casartar/Spiralboard/README.md

# Spiralboard

[Hier](Doku/Doku.md) gehts zur Anleitung.

## iBOM
[ibom.html](https://html-preview.github.io/?url=https://github.com/casartar/Spiralboard/blob/main/PCB/bom/ibom.html)
