casartar/Spiralboard/Doku/BeispielConfig/README.md

### Beispiele für die ledmap

- dazu muss das Spiralboard mit einem Netzwerk mit INternet verbunden sein, da sonst der editor nicht erreichbar ist.
- unter IP-SPIRALBOARD/edit ist dieser dann zu erreichen und man kann die ledmap1.json hochladen.

- wenn man dann in den Settings noch auf 2D Matrix umstellt  (0,0 ist links oben)
- und 64 LEDS anzahl angibt. kann man alle effekte nutzen. sowohl mit ledmap im 2D kontext als auch im 1D Kontext
- pro preset definierbar ob default oder ledmap1
- einige Beispiele dazu sind in der wled_presets.json zu finden

### mit pixart.htm kann man dann versuchen lustige bilder aufs spiralboard zu bekommen.
- auch hochladen über den editor und dann per URL aufrufen....
- rumspielen :)
