casartar/Spiralboard/Doku/Doku.md

# Spiralboard - Lötanleitung

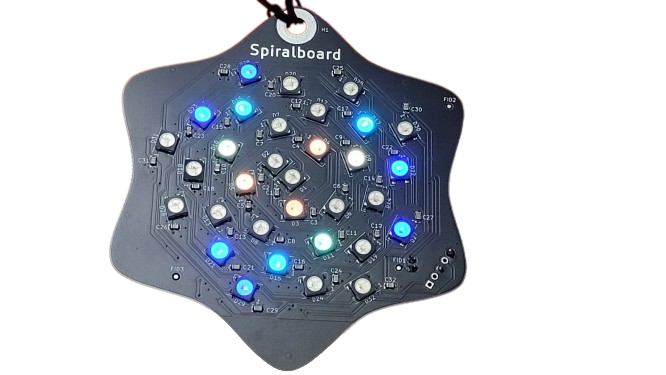
[picture p1: Doku/Bilder/20230919_221744-removebg-preview.png]


Das Spiralboard ist eine Demoplatine, anhand der wir die Fähigkeit unserer Pick and Place Maschine demonstrieren wollen. Darüber hinaus ist sie auch sehr schön anzusehen und macht sehr viel Spaß beim zusammenbauen (Das Spiralboard, nicht die Maschine).

Folgende Schritte sind notwendig um ein Spiralboard zu fertigen:
- Auftragen der Lötpaste Oberseite
- Automatische Bestückung Oberseite
- Backen der Platine
- Handbestücken der Unterseite
- Steuern der LEDs

Je nach Kenntnisstand kannst du alle Schritte, außer der automatischen Bestückung, mithilfe dieser Anleitung selbstständig durchführen. Dabei stehen wir dir jederzeit mit Rat und Tat zur Seite.

**Wichtig:** Bitte lies jeden Schritt erst zuende und schaue dir das Bild dazu an, bevor du anfängst ihn abzuarbeiten.

Das Herz der Platine ist ein **ESP8266-Modul** mit der Open Source Software **WLED**. Mithilfe von WLED kann das Spiralboard auf jede erdenkliche Art und Weise zum Leuchten und Blinken gebracht werden.

Und das von dir! - Mit deinem Smartphone!

## Schritt 1: Auftragen der Lötpaste

### Einlegen der Platine in den Schablonenhalter
Zuerst muss die Platine in den Schablonenhalter eingelegt werden, so dass die Platine rechts und unten an den Metallstegen anliegt. Die weißen Magnetplatten müssen so gegen die Platine geschoben werden, dass sie sich nicht mehr bewegen kann.

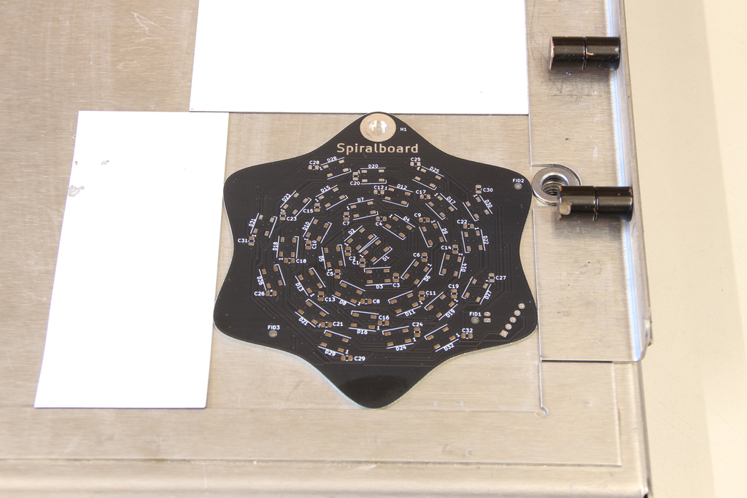
[picture p2: Doku/Bilder/IMG_8405.JPG]


### Auflegen der Lötschablone
Nun muss die Lötschablone (auch Stencil genannt) so auf die Platine aufgelegt werden, dass die Löcher in der Schablone und die silbernen Pads der Platine perfekt übereinander liegen.

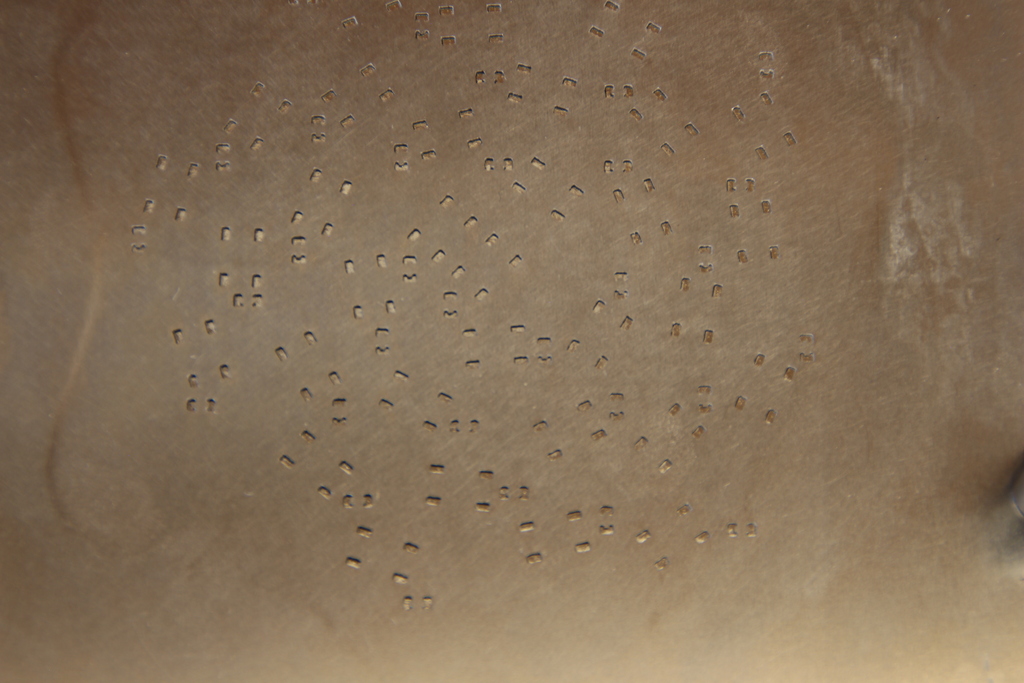
[picture p3: Doku/Bilder/IMG_8409.JPG]


Wenn alles perfekt passt, muss die Lötschablone mit den schwarzen Magneten am Scharnier des Schablonenhalters befestigt werden. Dabei muss darauf geachtet werden, dass die Schablone nicht wieder verrutscht. Das Scharnier beginnt erst ab ca. 2 cm von der unteren rechten Ecke. Die Magnete müssen also oberhalb platziert werden.

**Achtung**: Die Magnete sind ziemlich stark.

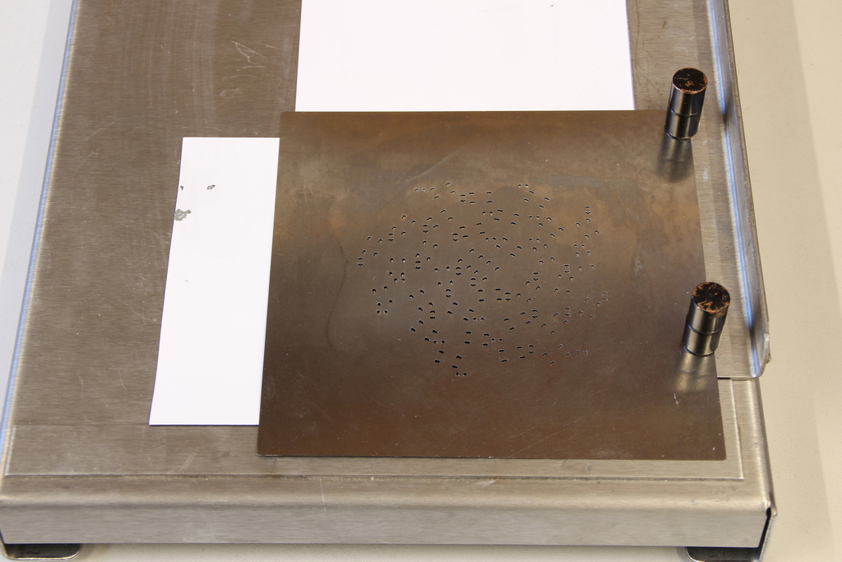
[picture p4: Doku/Bilder/IMG_8408.JPG]


### Auftragen der Lötpaste

Am unteren Rand der Lötschablone muss eine dünne Wurst aus Lötpaste aufgetragen werden. Die Wurst muss so breit sein, dass beim Rakeln alle Löcher in der Schablone gefüllt werden können.

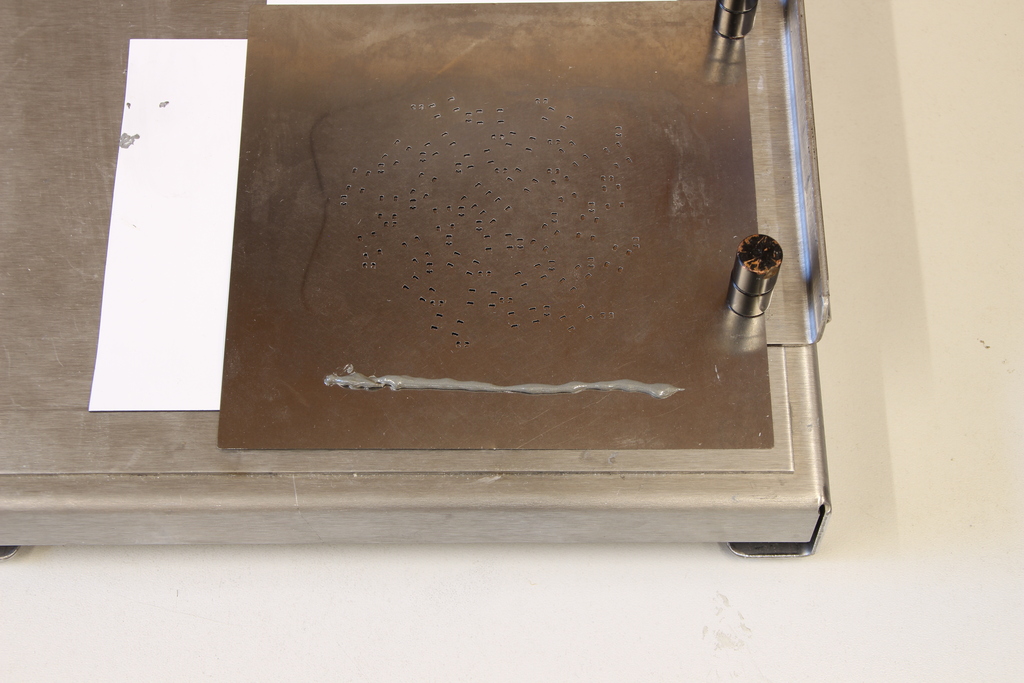
[picture p5: Doku/Bilder/IMG_8410.JPG]


Mit zwei Fingern wird die Lötschablone am unteren Rand fixiert und mit dem Rakel wird die Lötpaste über die Schablone gezogen. Dabei muss mit dem Daumen Druck auf den Rakel ausgeübt werden, damit die Lötpaste sich gut in die Öffnungen setzen kann.

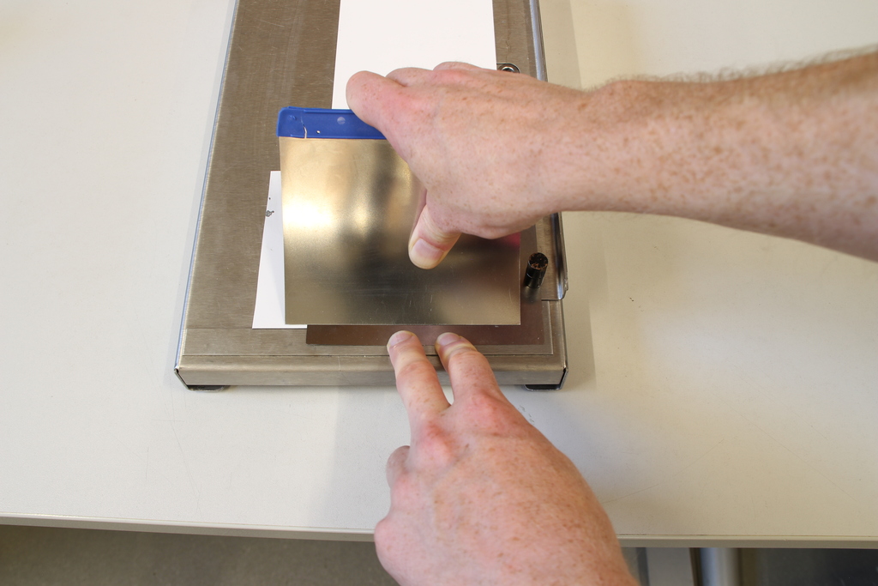
[picture p6: Doku/Bilder/IMG_8411.JPG]


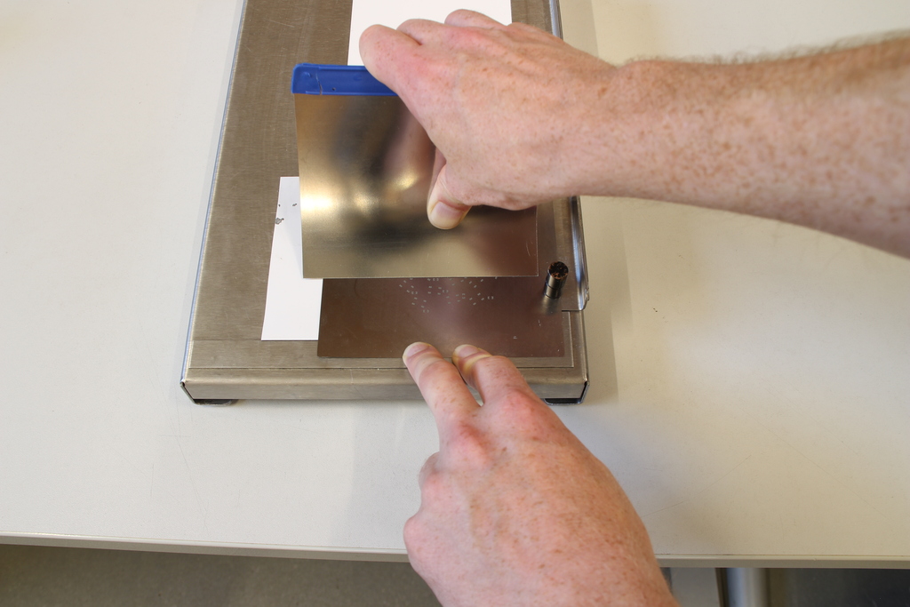
[picture p7: Doku/Bilder/IMG_8412.JPG]


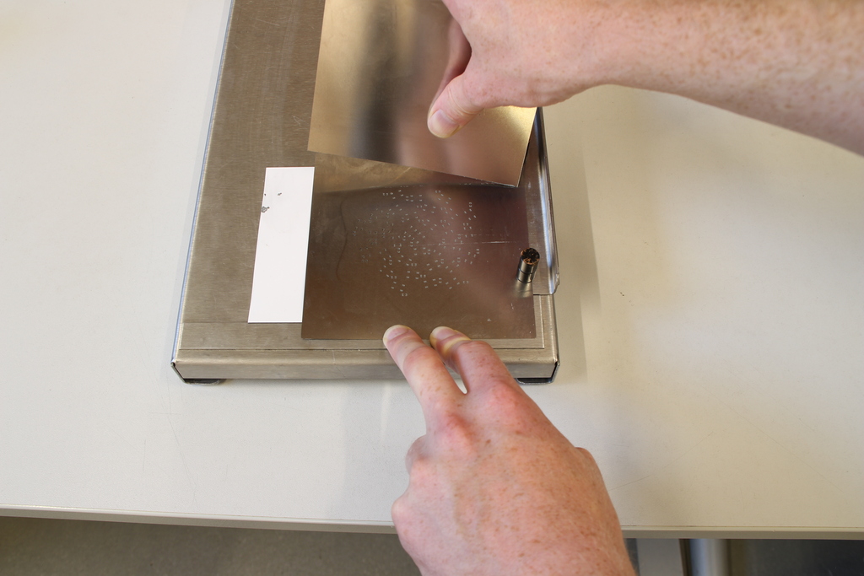
[picture p8: Doku/Bilder/IMG_8413.JPG]


Zum Entfernen der Schablone wird mit dem rechten Daumen das Scharnier des Schablonenhalters blockiert und mit dem linken Zeigefinger die linke untere Ecke der Schablone angehoben. 

Hier muss darauf geachtet werden, dass die Schablone nicht zurückfällt, sonst kann die Lötpaste verschmiert werden.

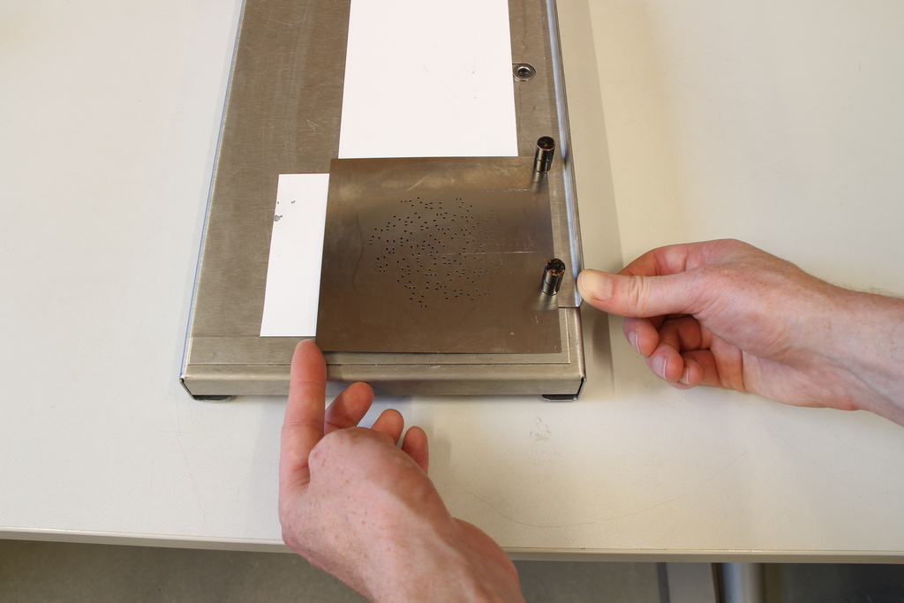
[picture p9: Doku/Bilder/IMG_8414.JPG]


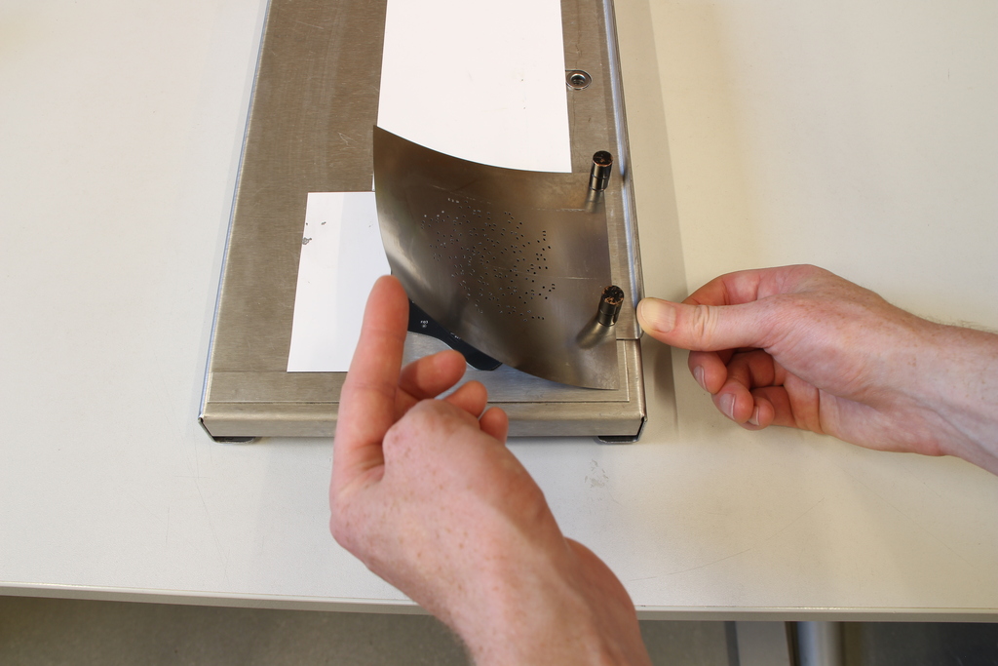
[picture p10: Doku/Bilder/IMG_8415.JPG]


Nachdem sich die Schablone komplett von der Platine gelöst hat, kann die Blockierung des Scharniers gelöst werden und das Scharnier mit der Schablone aufgeklappt werden.

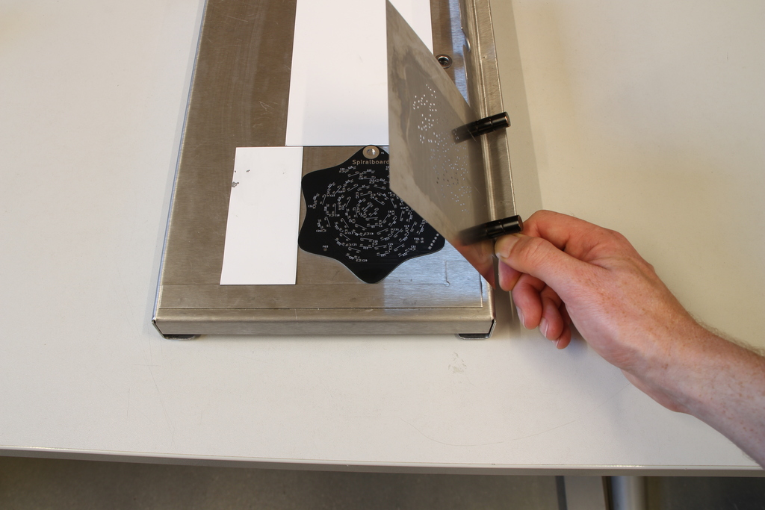
[picture p11: Doku/Bilder/IMG_8416.JPG]


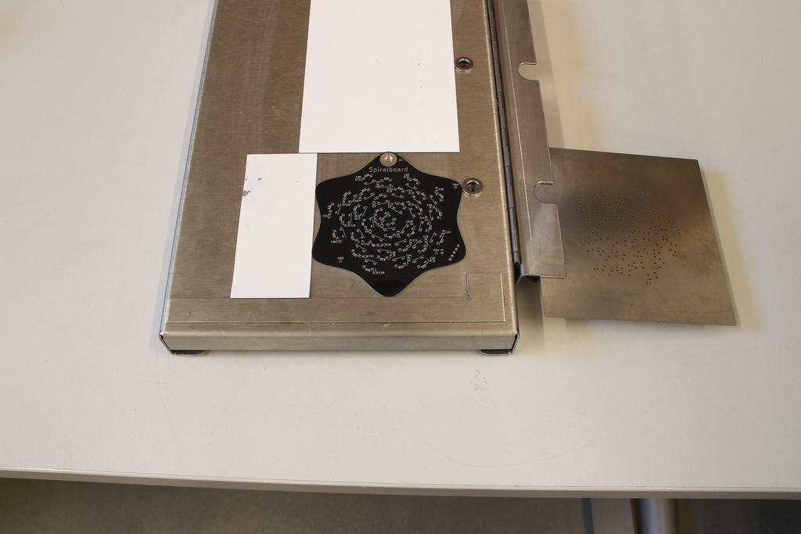
[picture p12: Doku/Bilder/IMG_8417.JPG]


Nun folgt die Kontrolle, ob die Lötpaste bündig auf den Pads aufgetragen ist. Ist dies nicht der Fall, muss die Platine zuerst komplett gereinigt und dann der ganze Vorgang wiederholt werden.

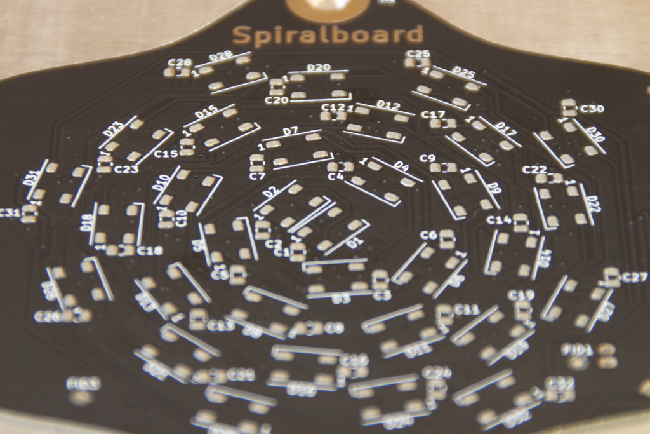
[picture p13: Doku/Bilder/IMG_8418.JPG]


## Schritt 2: Automatische Bestückung

Die Oberseite der Platine wird automatisch in der Pick and Place Maschine bestückt. Dazu muss die Platine in den dafür vorgesehenen Halter eingelegt werden.

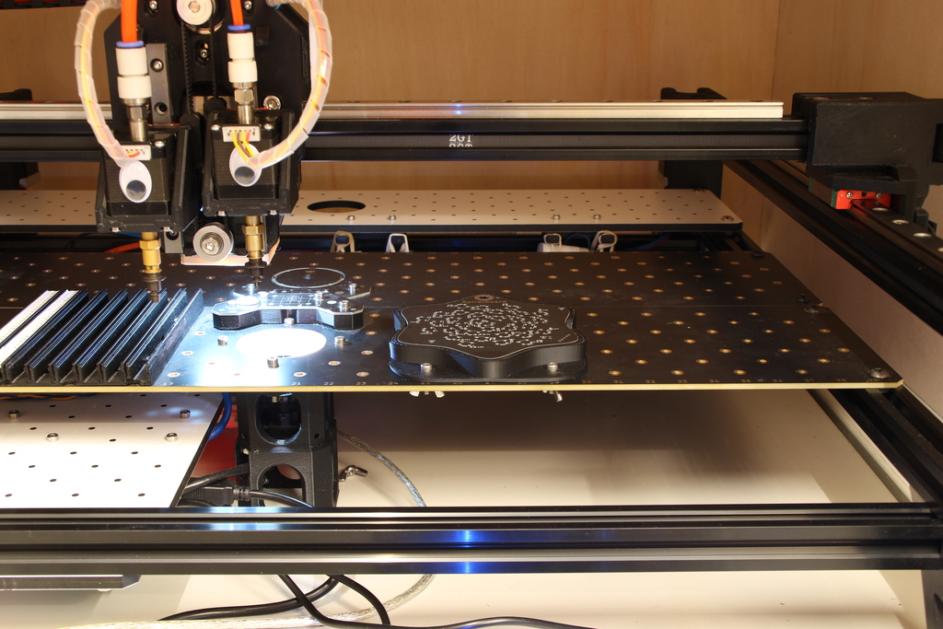
[picture p14: Doku/Bilder/IMG_8419.JPG]


Auf der Oberseite werden die LEDs und 100 nF Kondensatoren platziert.

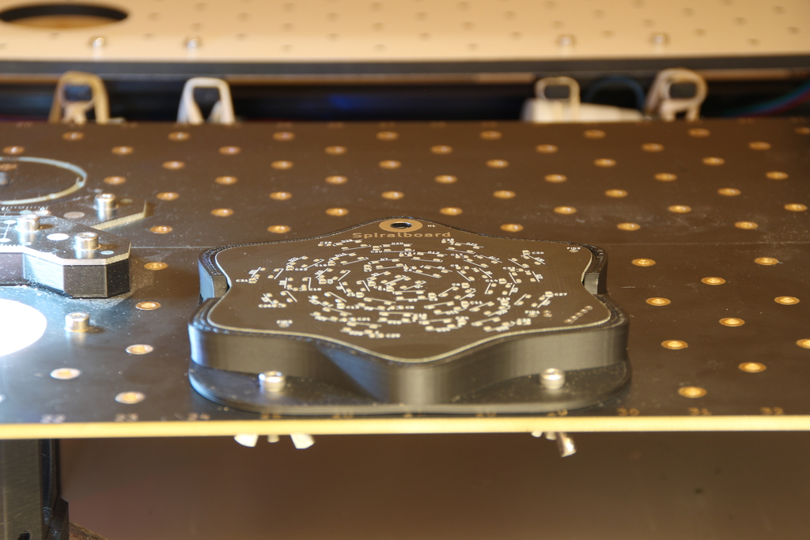
[picture p15: Doku/Bilder/IMG_8420.JPG]


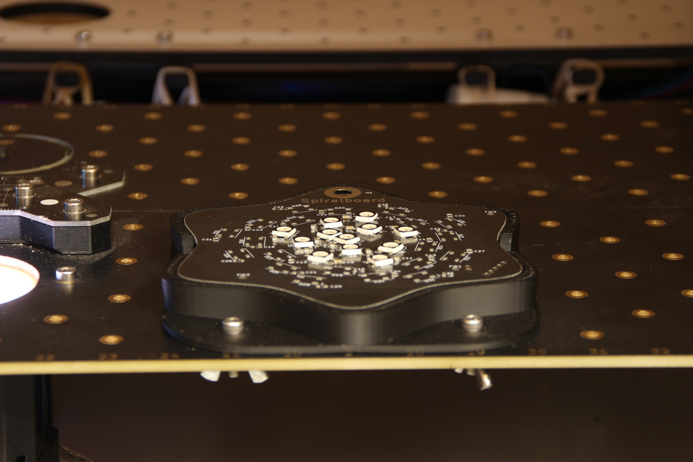
[picture p16: Doku/Bilder/IMG_8421.JPG]


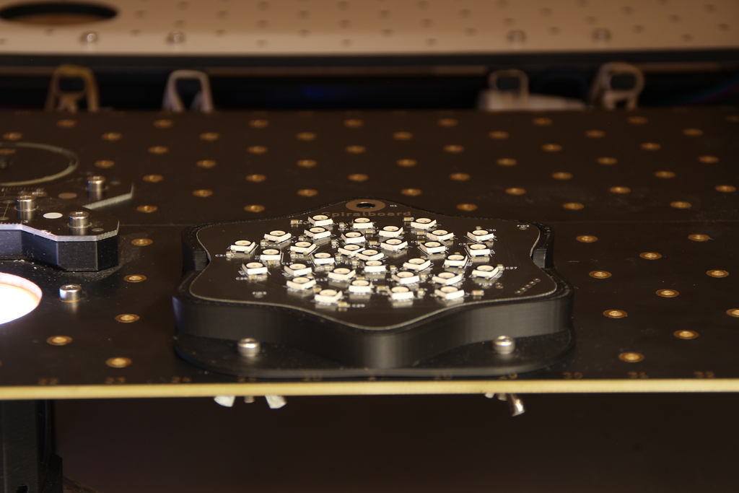
[picture p17: Doku/Bilder/IMG_8422.JPG]


## Backen der Platine

Die bestückte Platine muss jetzt im Lötofen gebacken werden.

Dazu wird die Platine vorsichtig mittig in den Ofen eingelegt, die Tür geschlossen, der Timer maximal aufgezogen und der Heizvorgang mit dem grünen Taster gestartet.

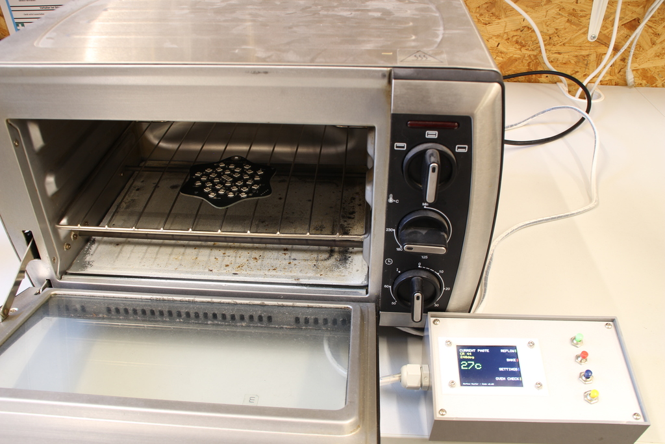
[picture p18: Doku/Bilder/IMG_8423.JPG]


Auf dem Display kann der Temperaturverlauf verfolgt werden.

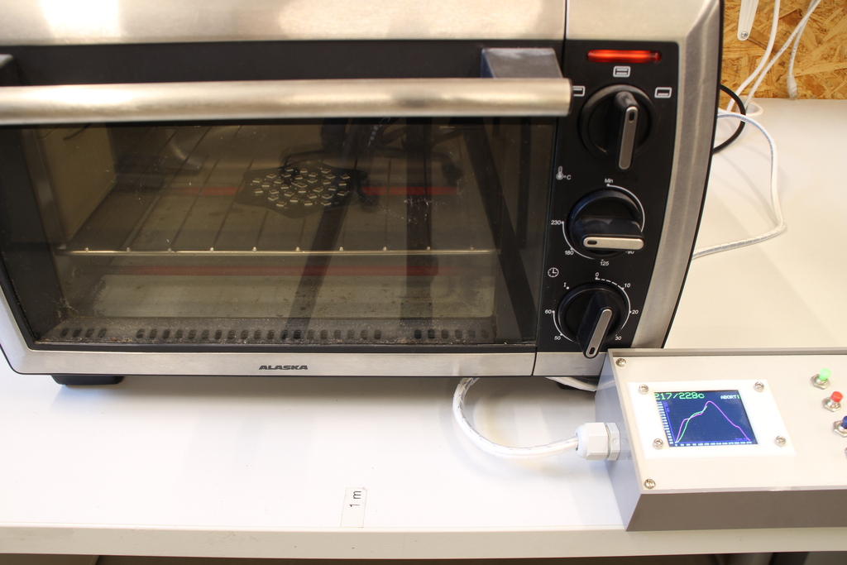
[picture p19: Doku/Bilder/IMG_8424.JPG]


Nach Beenden des Heizvorgangs verbleibt die Platine noch für 2-3 Minuten bei geschlossener Tür im Ofen, egal was das Display sagt.

Anschließend wird die Tür für ca. 1 Minute einen Spalt breit geöffnet.

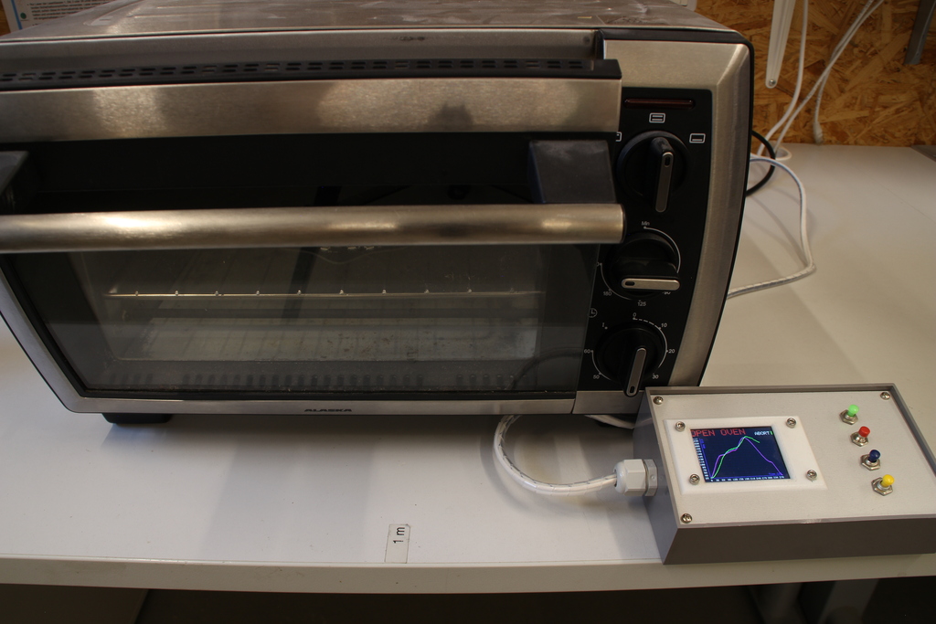
[picture p20: Doku/Bilder/IMG_8425.JPG]


Daraufhin wird der Ofen komplett geöffnet und die heiße Platine mit einer Pinzette entnommen.

Zum Schluss wird geprüft, ob alle Bauteile ordungsgemäß verlötet wurden.

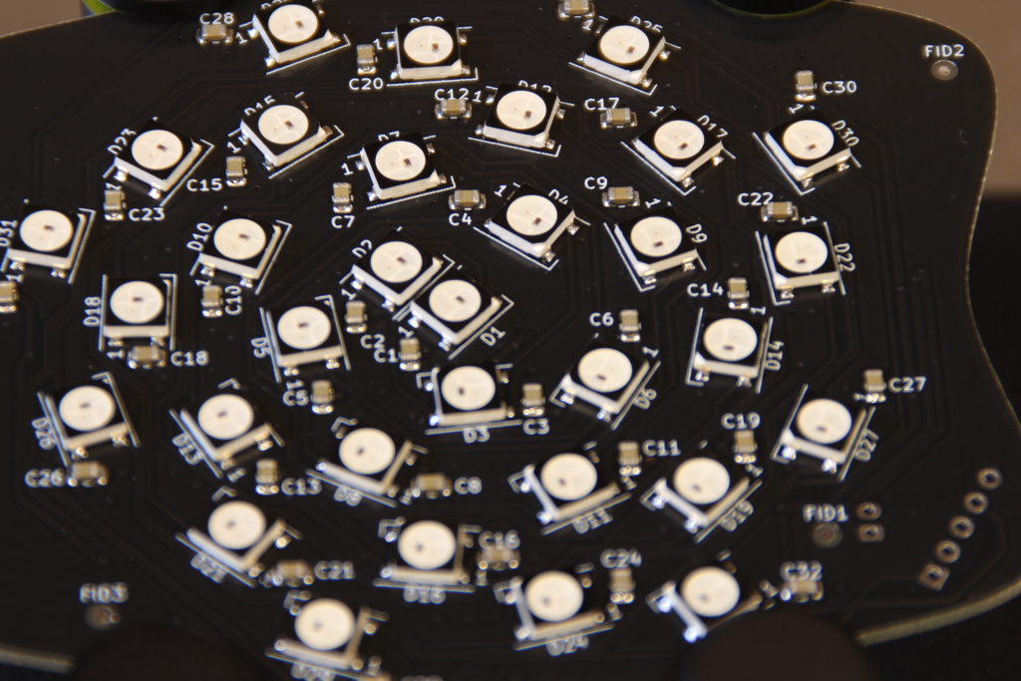
[picture p21: Doku/Bilder/IMG_8427.JPG]


## Schritt 3: Handbestückung der Unterseite
### Alle Bauteile auf einen Blick

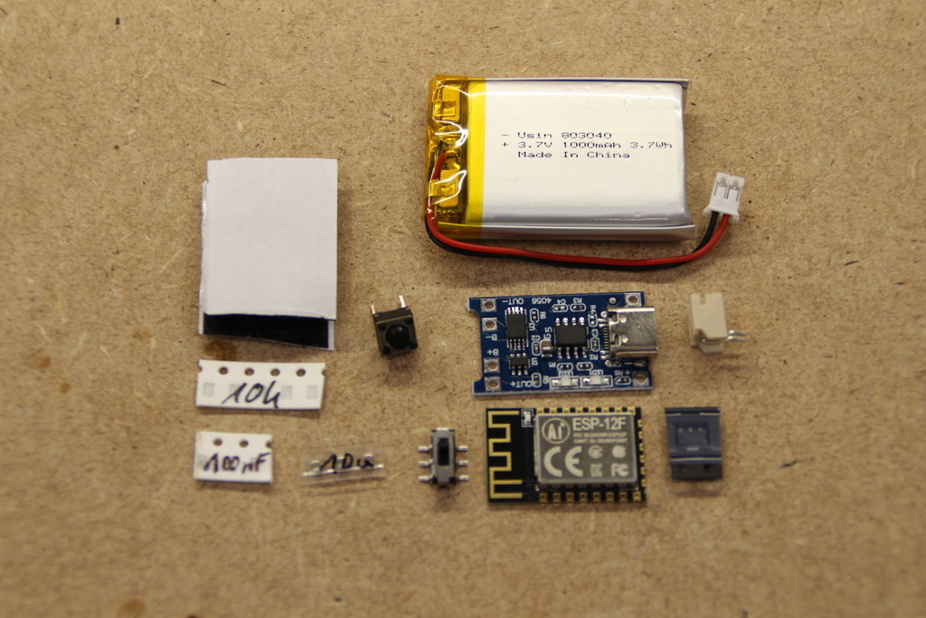
[picture p22: Doku/Bilder/IMG_8443.JPG]


### Einspannen der Platine

Damit während des Lötens die Platine nicht verrutscht, wird diese mit sogenannten PCBites auf einer magnetischen Unterlage fixiert.

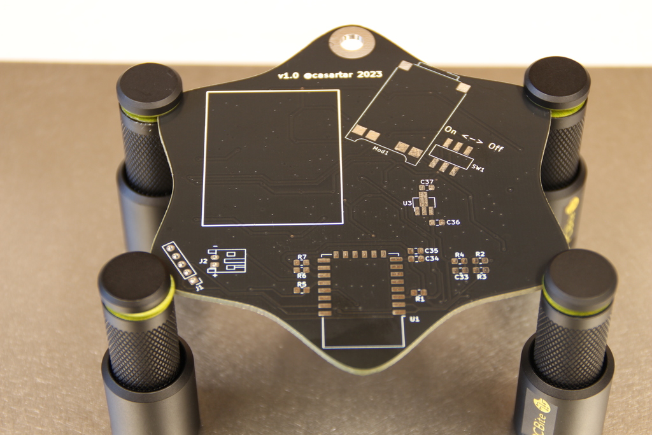
[picture p23: Doku/Bilder/IMG_8441.JPG]


### Widerstände - R1, R4, R5, R6 und R7 (10 kΩ)

Die Widerstände sind in einem weißen Papiergurt verpackt, der mit der Aufschrift "10k" versehen ist.
Um die Widerstände aus dem Gurt zu lösen, muss die Plasikfolie entfernt werden. Das geht am Besten, wenn man mit der Pinzette zwischen Folie und Papier sticht und die Folie vorsichtig abzieht, so dass die Widerstände nicht wegspringen.

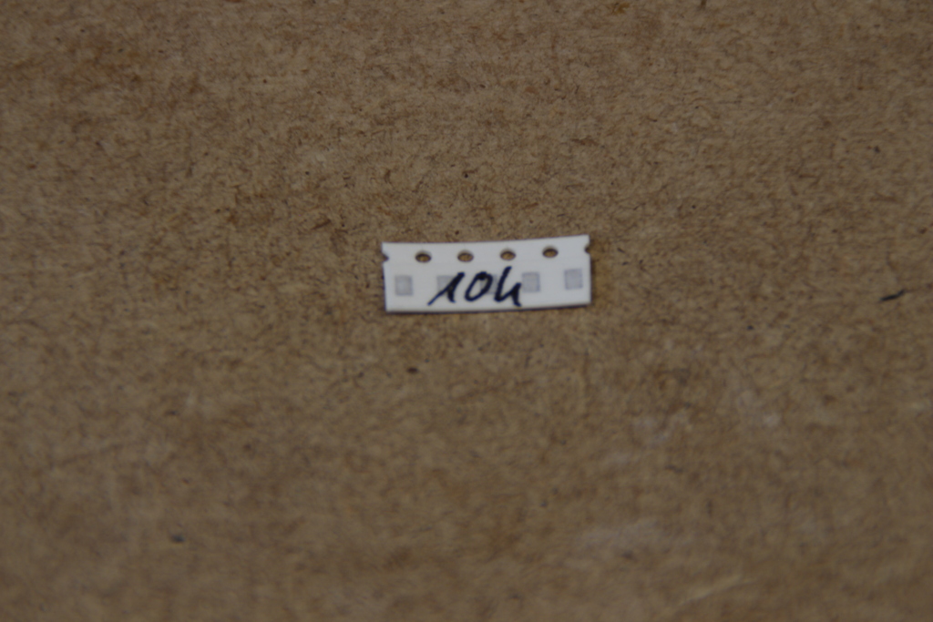
[picture p24: Doku/Bilder/IMG_8431.JPG]


Im ersten Schritt wird das rechte Pad des mit "R1" beschrifteten Footprints verzinnt.

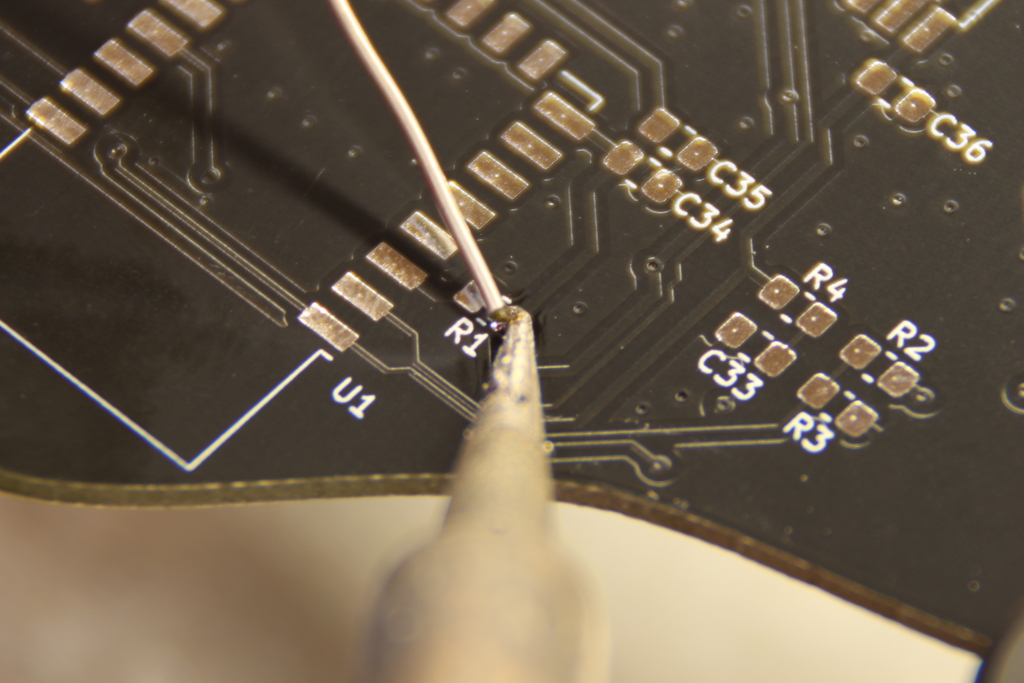
[picture p25: Doku/Bilder/IMG_8446.JPG]


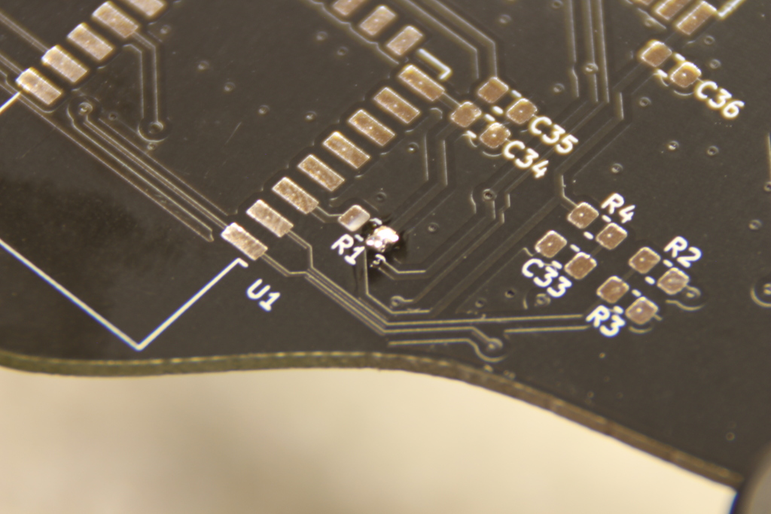
[picture p26: Doku/Bilder/IMG_8447.JPG]


Anschließend wird der Widerstand mit der Pinzette aufgenommen und mit dem Lötkolben das Lötzinn wieder flüssig gemacht. Gleichzeitig muss der Widerstand in das flüssige Lötzin hineingeschoben werden.

Ist der Widerstand an der korrekten Stelle platziert, wird der Lötkolben entfernt und der Widerstand mit der Pinzette noch so lange festgehalten, bis das Lötzinn fest geworden ist.

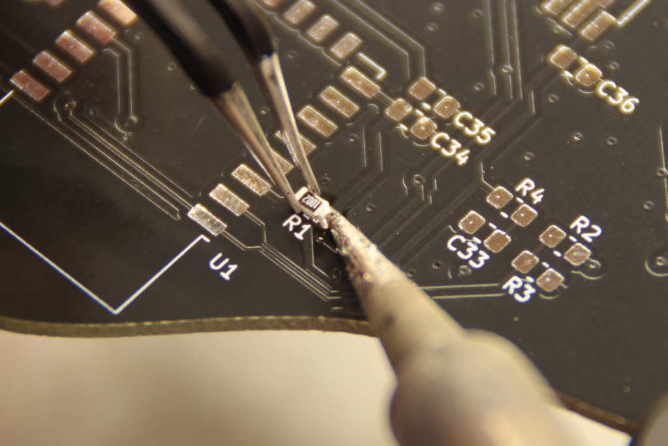
[picture p27: Doku/Bilder/IMG_8449.JPG]


Nun wird die andere Seite des Widerstands mit dem zweiten Pad verlötet.

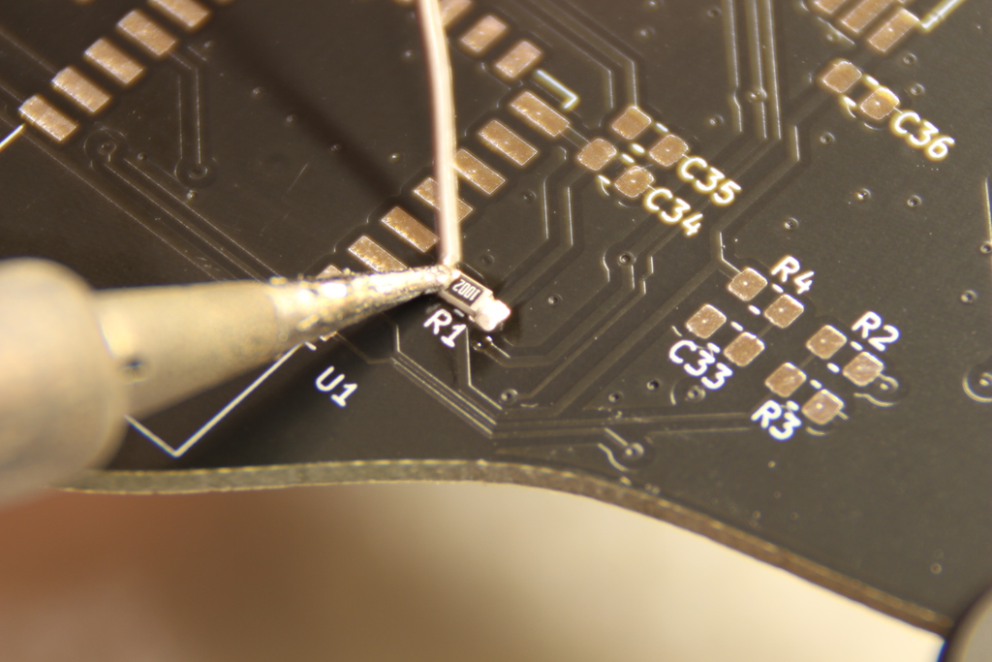
[picture p28: Doku/Bilder/IMG_8450.JPG]


Der gleiche Vorgang muss mit R4, R5, R6 und R7 wiederholt werden.

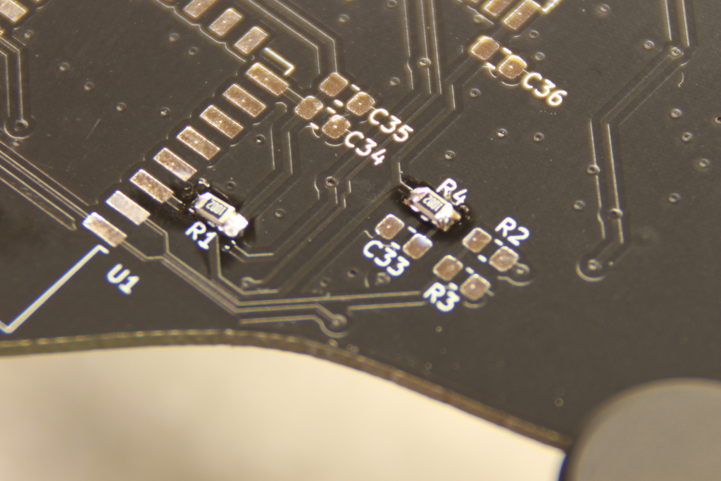
[picture p29: Doku/Bilder/IMG_8451.JPG]


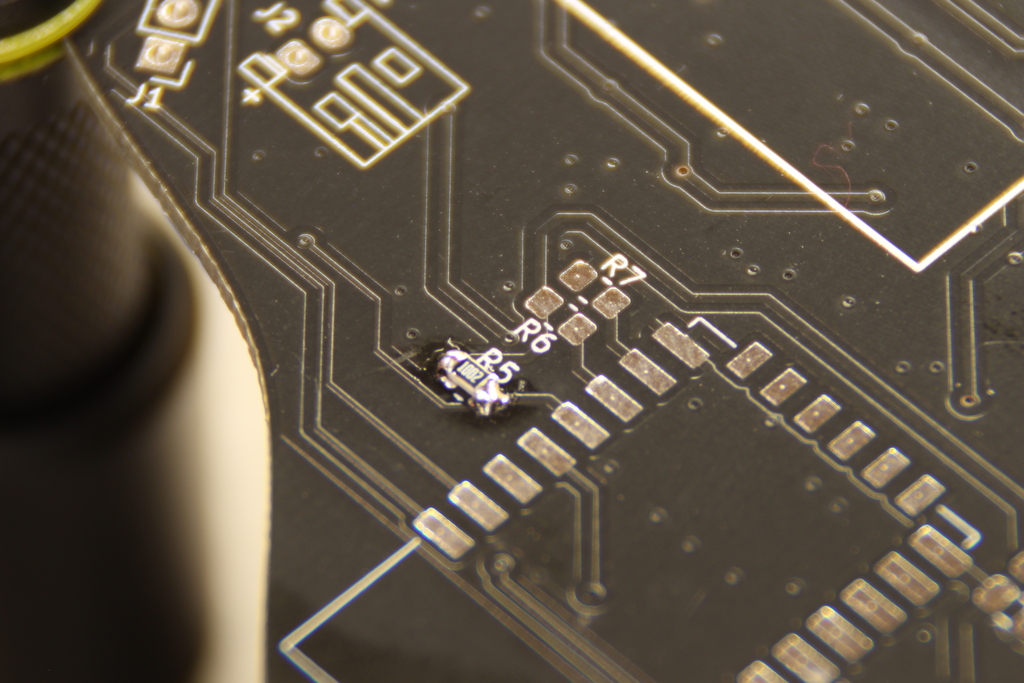
[picture p30: Doku/Bilder/IMG_8452.JPG]


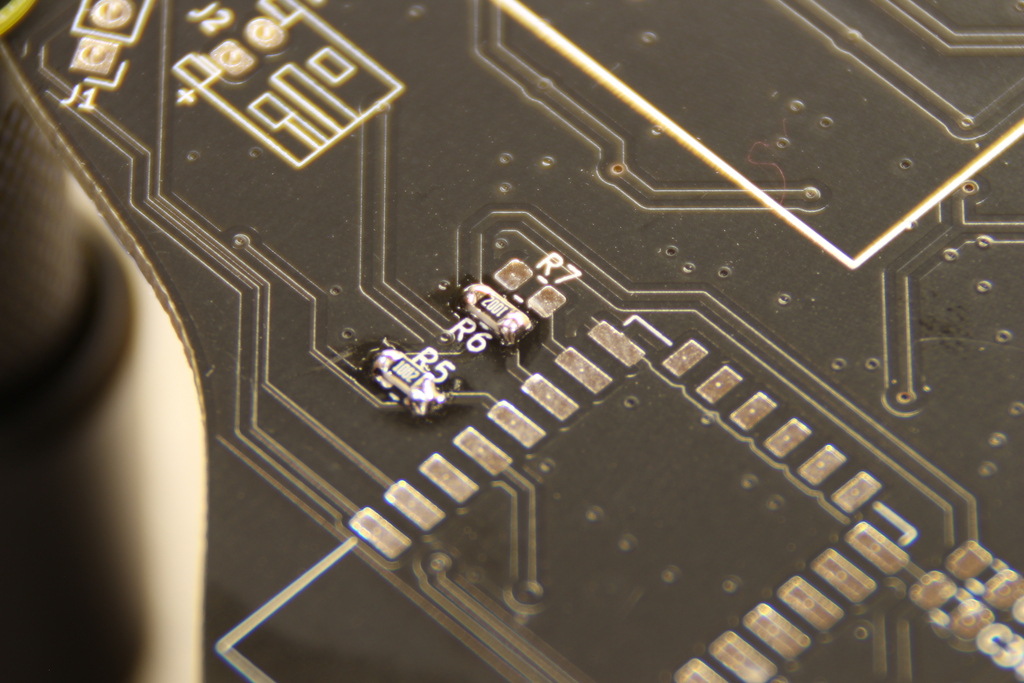
[picture p31: Doku/Bilder/IMG_8453.JPG]


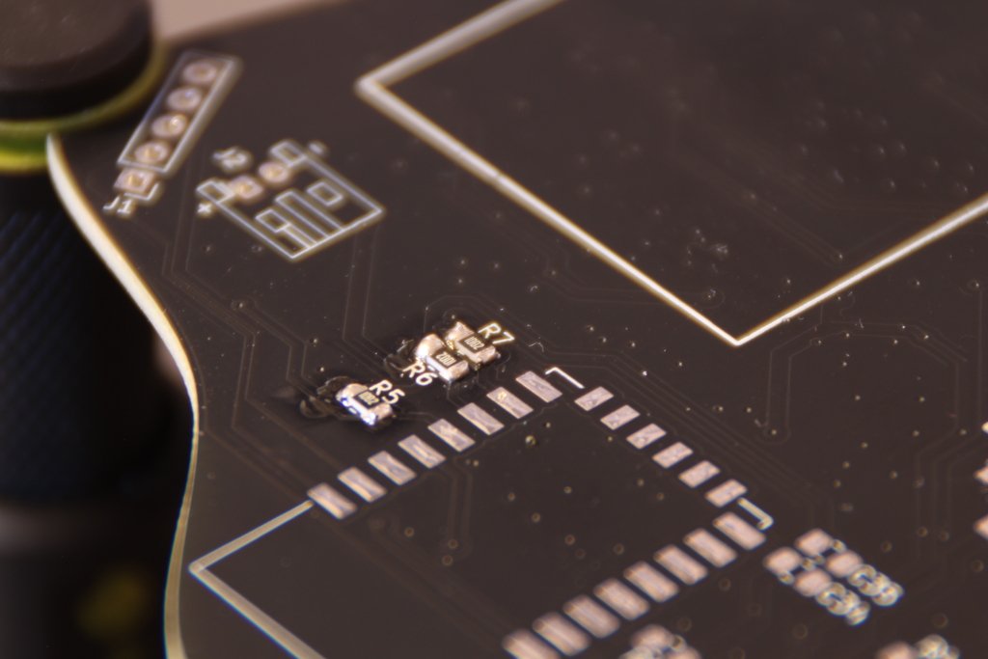
[picture p32: Doku/Bilder/IMG_9915.JPG]


### Kondensatoren - C33 und C34 (100 nF)

Die 100 nF-Kondensatoren sind ebenso wie die Widerstände in einem weißen Papiergurt verpackt, der mit der Aufschrift "100nF" versehen ist.

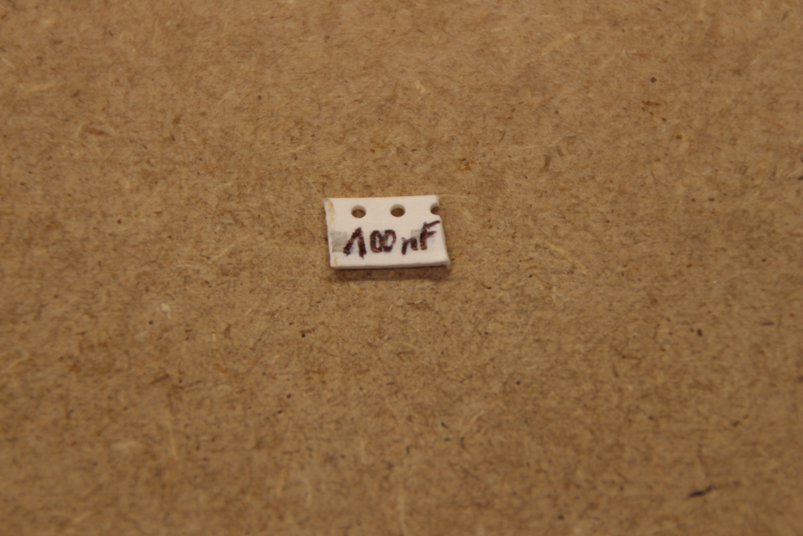
[picture p33: Doku/Bilder/IMG_8444.JPG]


Sie werden auch in gleicher Manier wie die Widerstände verlötet. Die Richtung (welche Seite wohin) ist egal, diese Kondensatoren sind nicht gepolt.

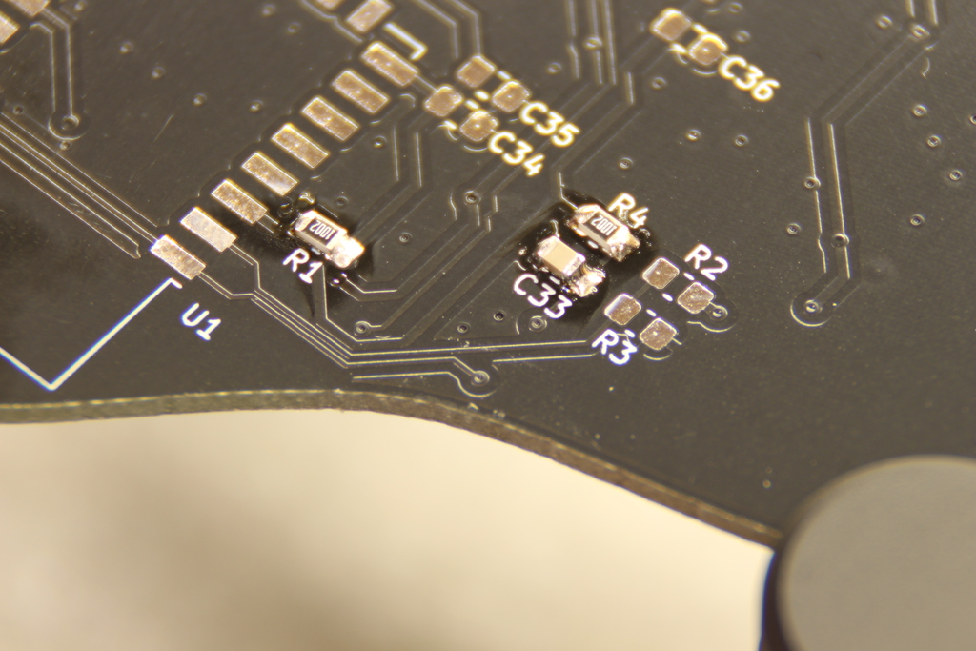
[picture p34: Doku/Bilder/IMG_8455.JPG]


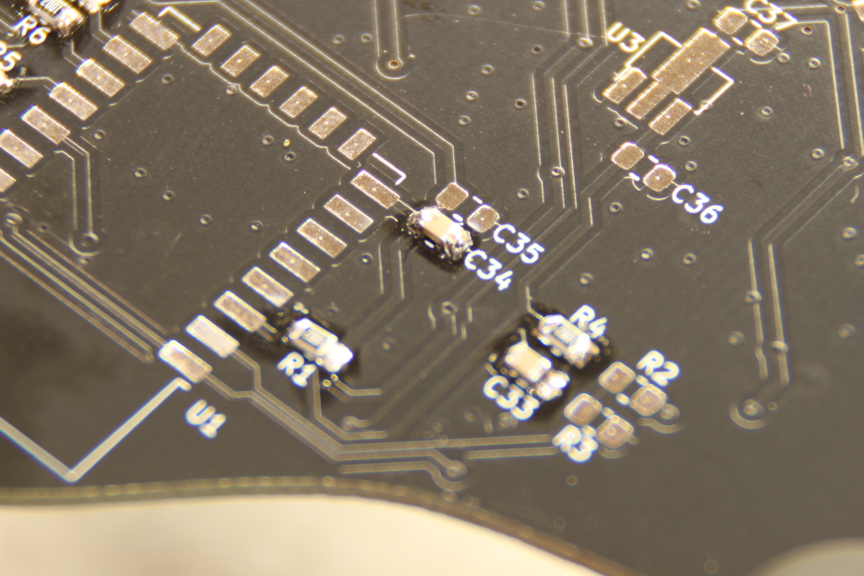
[picture p35: Doku/Bilder/IMG_8456.JPG]


### Kondensatoren - C35, C36 und C37 (10 µF)

Die 10 µF-Kondensatoren sind in einem transparenten Plastikgurt verpackt, der mit der Aufschrift "10u" versehen ist.
Auch hier: Gleiches Vorgehen wie bei den anderen Kondensatoren und Widerständen.

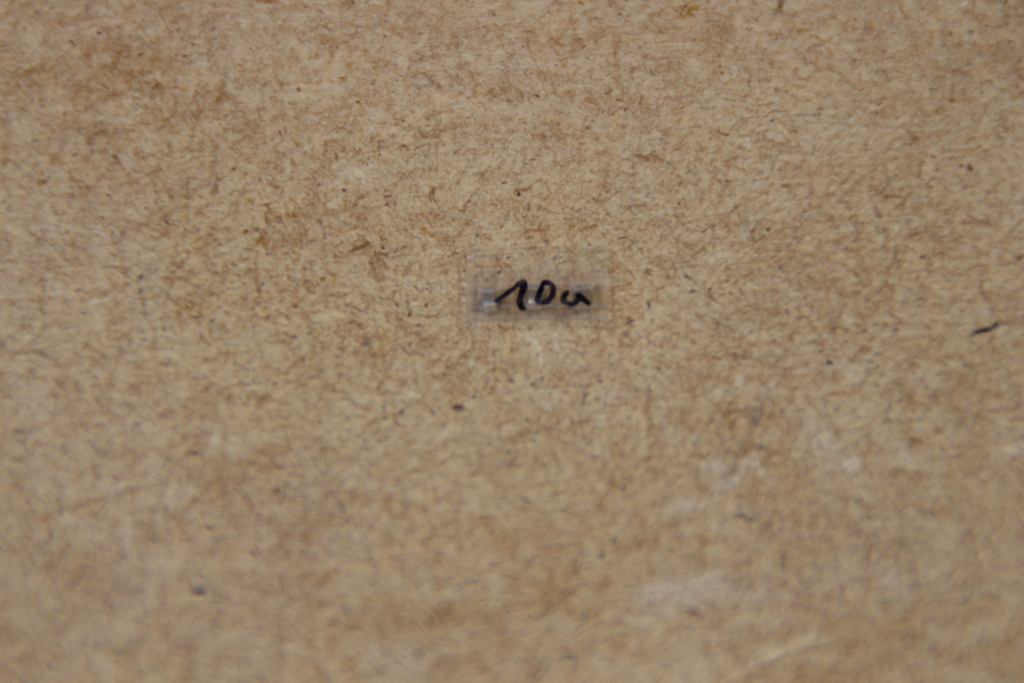
[picture p36: Doku/Bilder/IMG_8432.JPG]


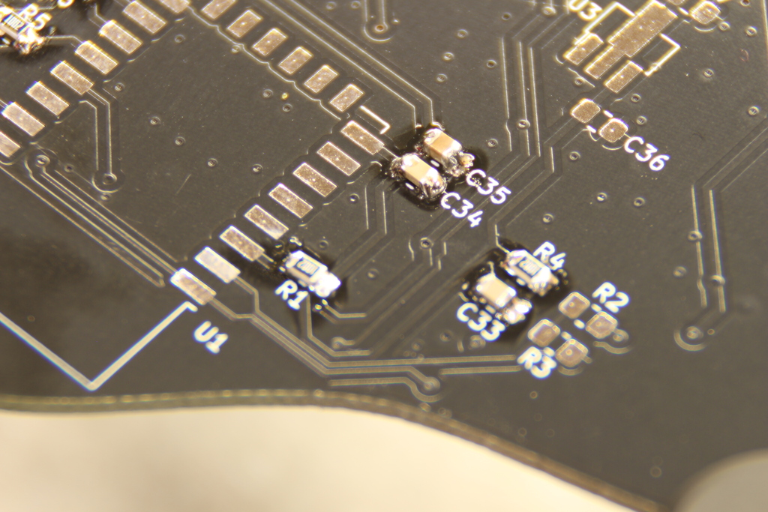
[picture p37: Doku/Bilder/IMG_8457.JPG]


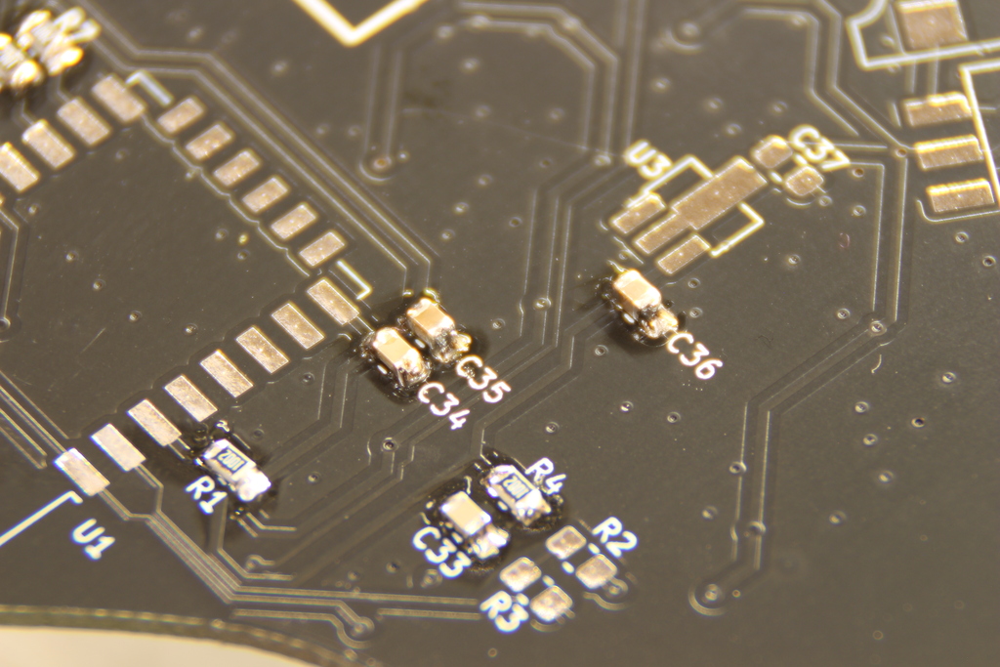
[picture p38: Doku/Bilder/IMG_8458.JPG]


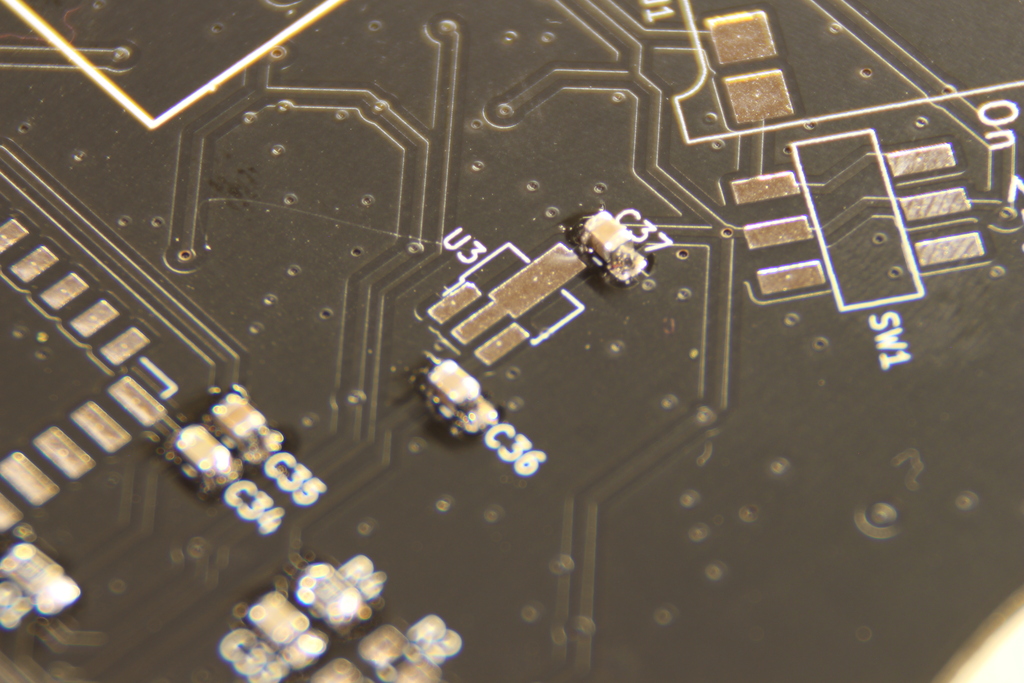
[picture p39: Doku/Bilder/IMG_8459.JPG]


### Linearregler - U3

Der Linearregler ist in einem schwarzen Plastikgurt verpackt.

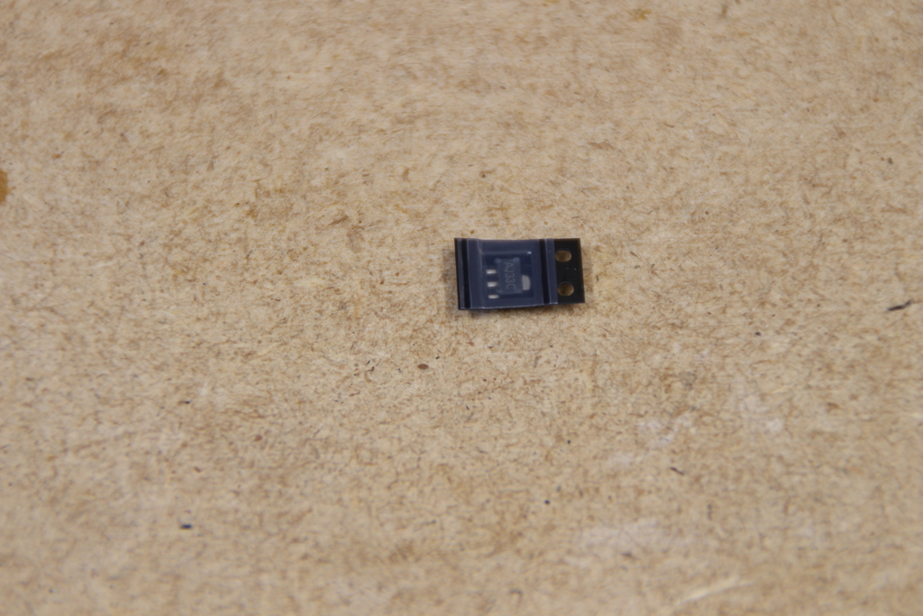
[picture p40: Doku/Bilder/IMG_8433.JPG]


Auch hier wird zuerst ein Pad verzinnt und dann das Bauteil in das flüssige Lötzinn geschoben. 

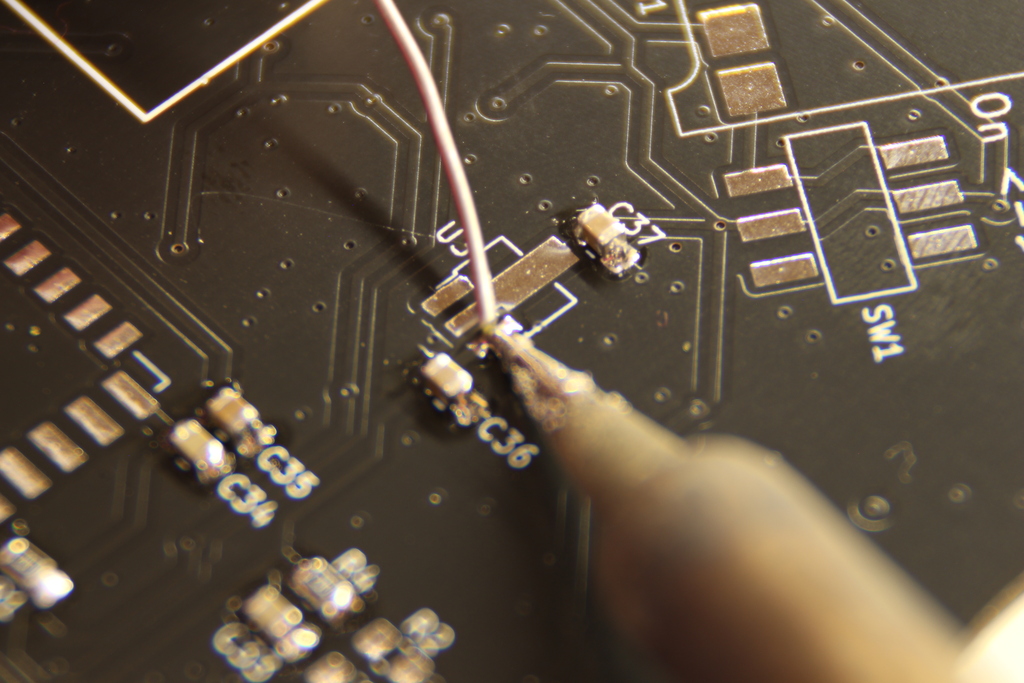
[picture p41: Doku/Bilder/IMG_8460.JPG]


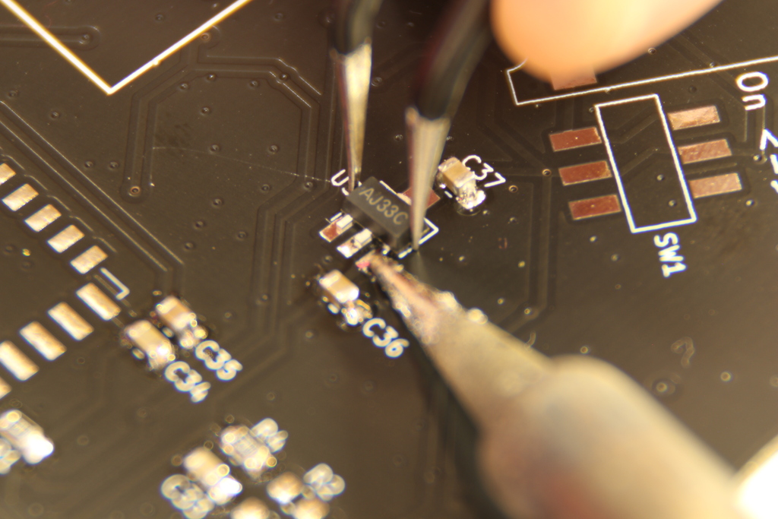
[picture p42: Doku/Bilder/IMG_8461.JPG]


Wenn das Bauteil sitzt, werden die restlichen Beine und die Kühlfahne verlötet.

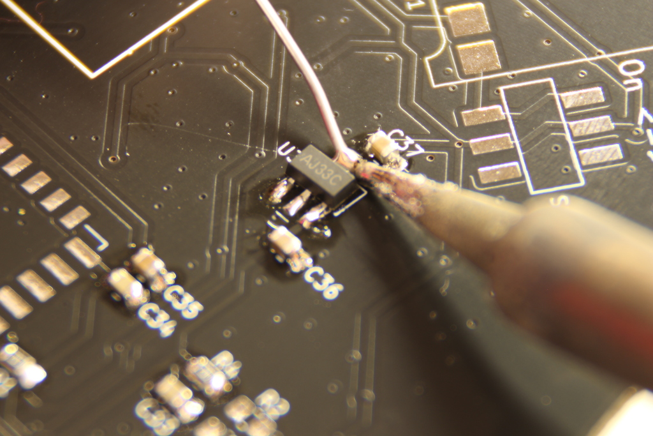
[picture p43: Doku/Bilder/IMG_8462.JPG]


### Schalter - SW1

Beim Schalter ist die Ausrichtung egal. 

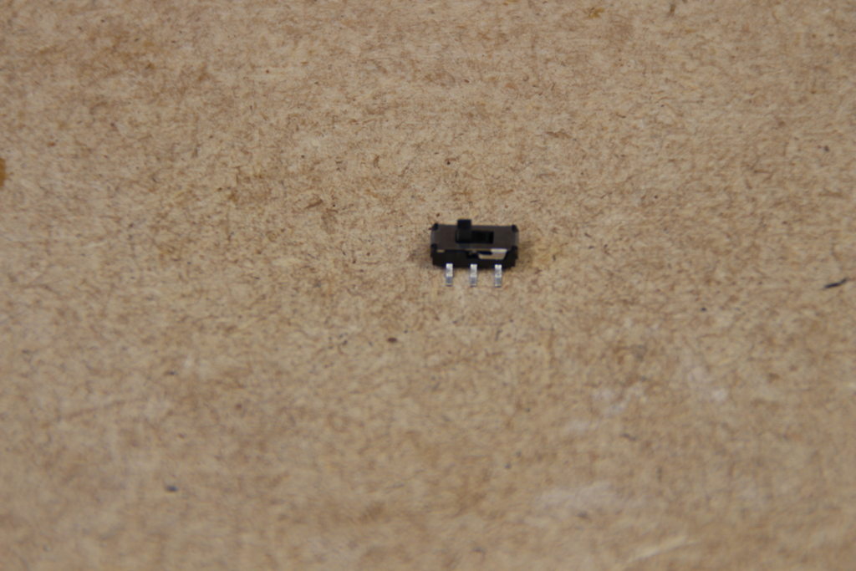
[picture p44: Doku/Bilder/IMG_8434.JPG]


Verlötet wird er, wie bisher gelernt.

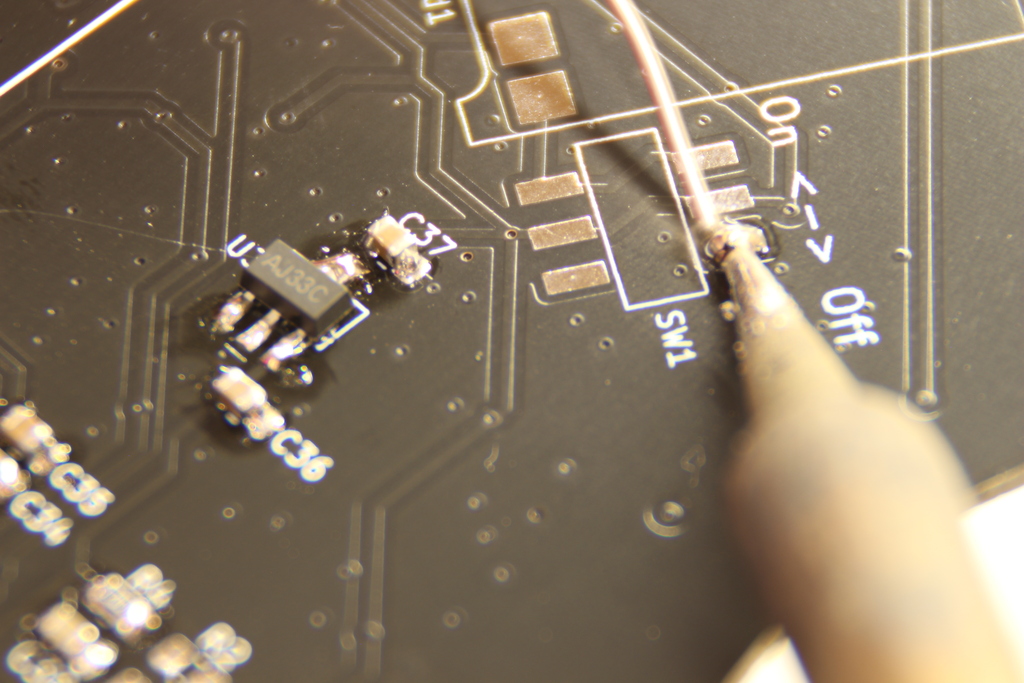
[picture p45: Doku/Bilder/IMG_8463.JPG]


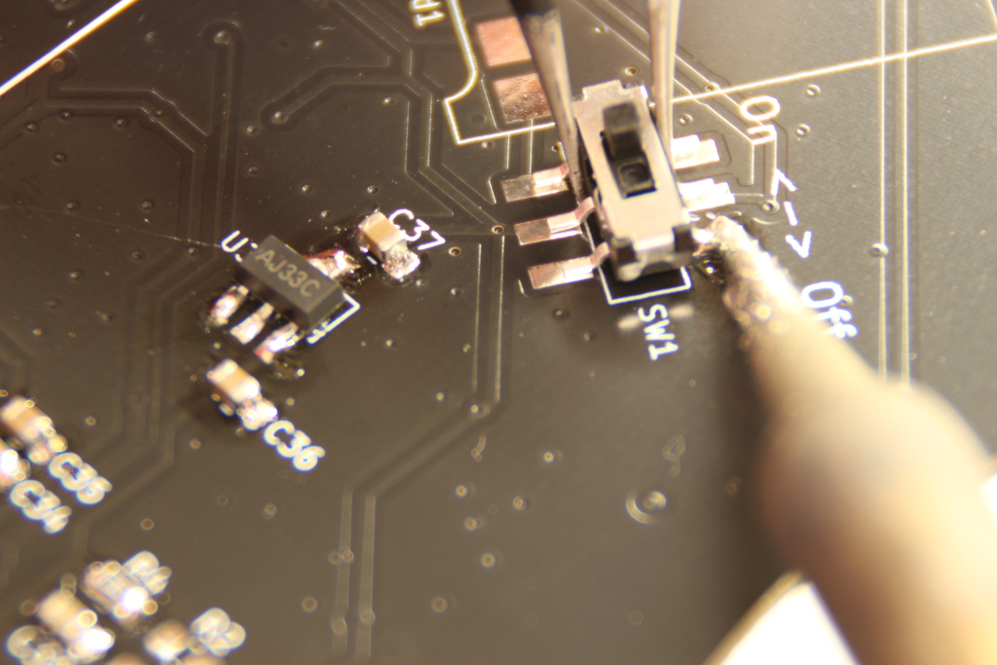
[picture p46: Doku/Bilder/IMG_8464.JPG]


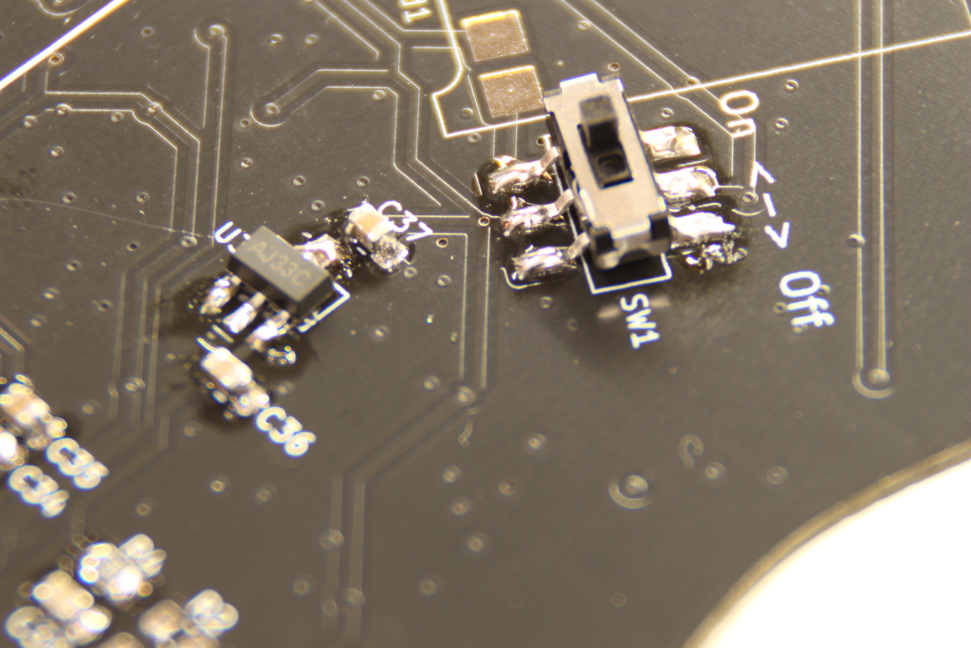
[picture p47: Doku/Bilder/IMG_8465.JPG]


### ESP8266-Modul - U1

Das ESP8266-Modul kann von Hand und ohne Pinzette platziert werden.

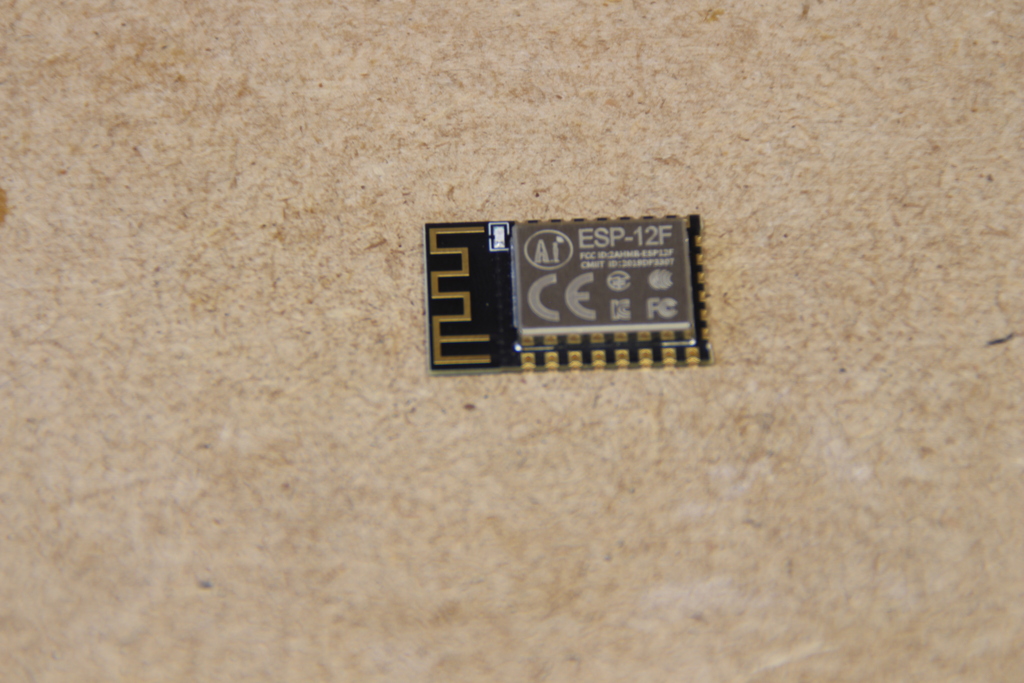
[picture p48: Doku/Bilder/IMG_8435.JPG]


Wie bisher auch wird zu erst ein Pad verzinnt und das Modul in das flüssige Lötzinn geschoben. Hier ist es ganz wichtig darauf zu achten, dass das Modul ordentlich sitzt und jeder Pin über einem Pad platziert ist. 

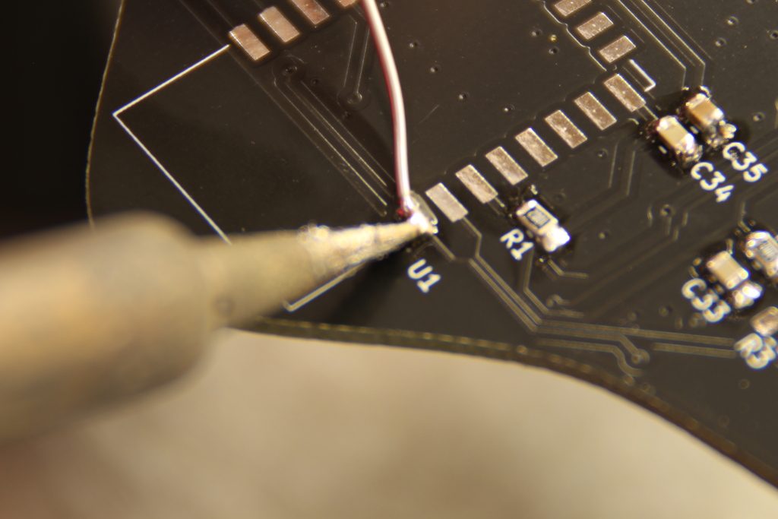
[picture p49: Doku/Bilder/IMG_8467.JPG]


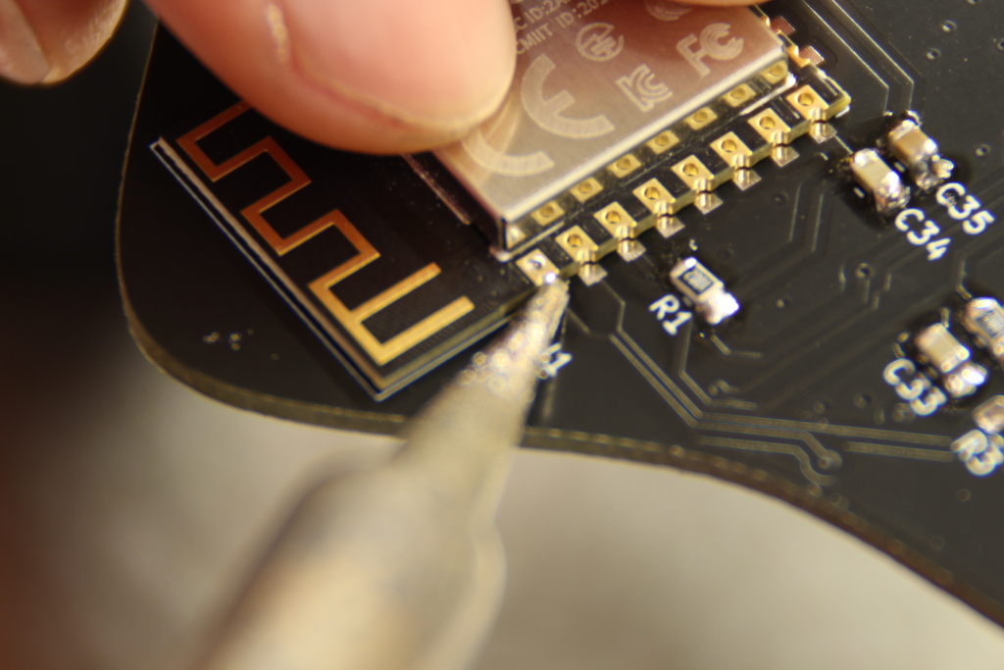
[picture p50: Doku/Bilder/IMG_8468.JPG]


Es genügt, nur die Pins an den beiden langen Seiten zu verlöten. Die Pinreihe an der kurzen Seite wird nicht benötigt.

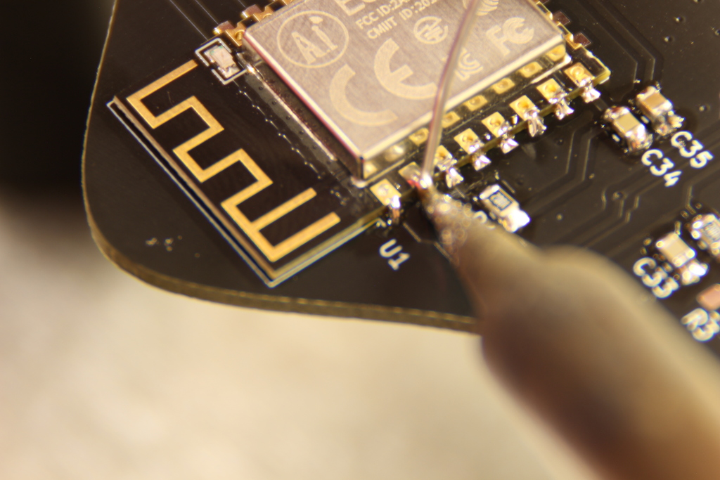
[picture p51: Doku/Bilder/IMG_8469.JPG]


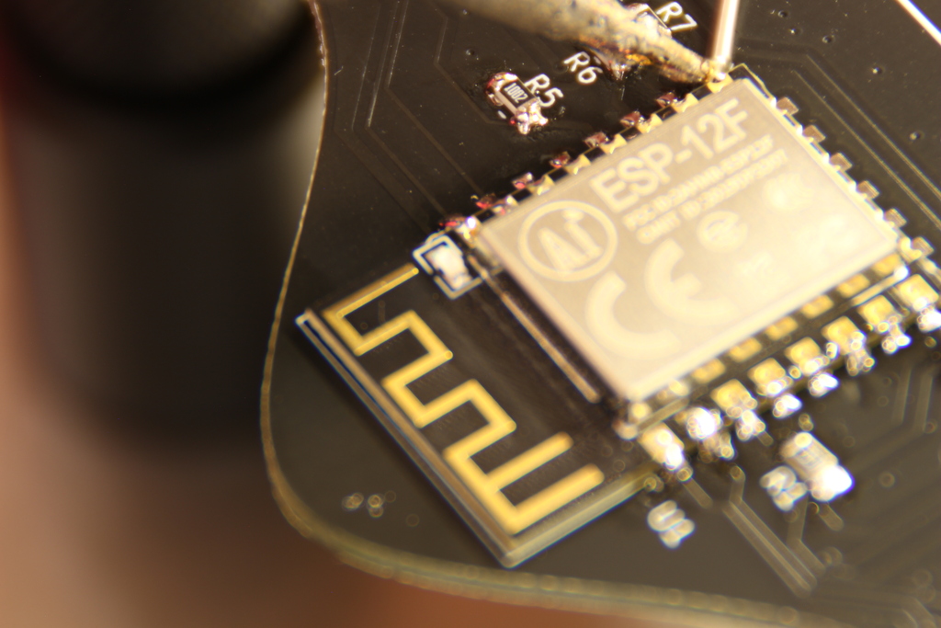
[picture p52: Doku/Bilder/IMG_8470.JPG]


### Ladereglermodul - Mod1

Für das Laderegler-Modul ist ebenfalls keine Pinzette notwendig. 

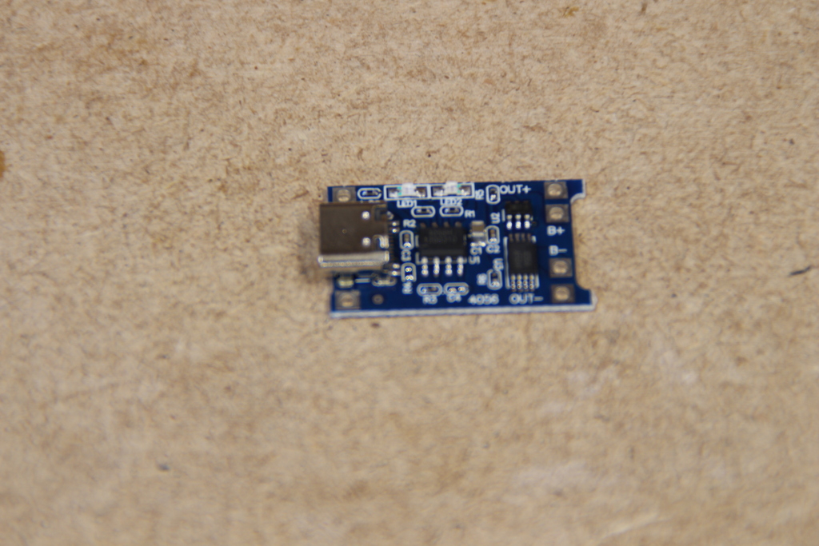
[picture p53: Doku/Bilder/IMG_8436.JPG]


Routiniert wird wieder ein Pad verzinnt und das Modul ausgerichtet. Zum Verlöten muss der Lötkolben durch die Bohrung gesteckt werden um das Lötzinn auf dem vorverzinnten Pad zu verflüssigen.

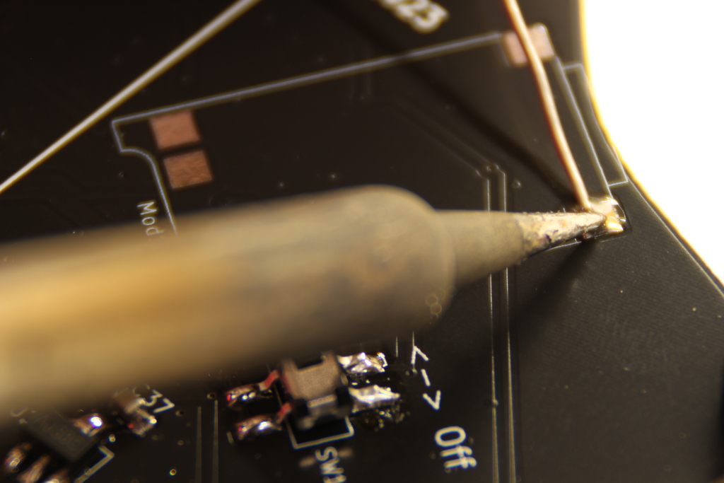
[picture p54: Doku/Bilder/IMG_8471.JPG]


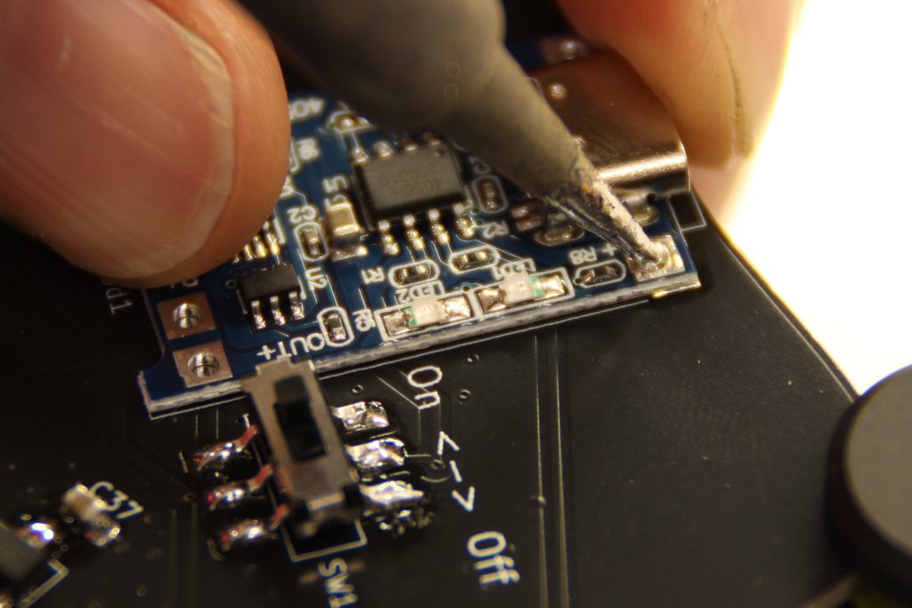
[picture p55: Doku/Bilder/IMG_8474.JPG]


Anschließend werden alle anderen Pads verlötet, indem Lötzinn in die Bohrungen gedrückt wird und alles mit dem Lötkolben erhitzt wird.

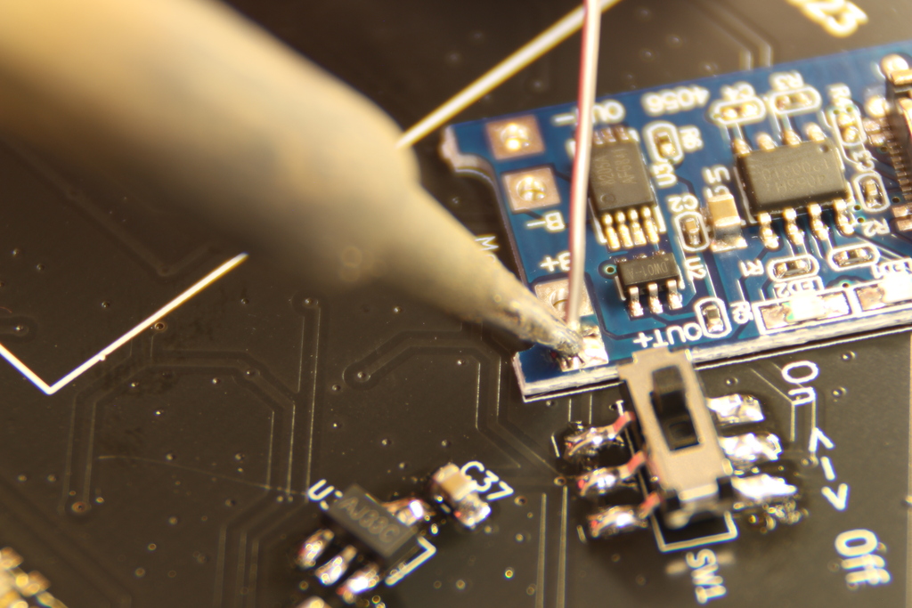
[picture p56: Doku/Bilder/IMG_8475.JPG]


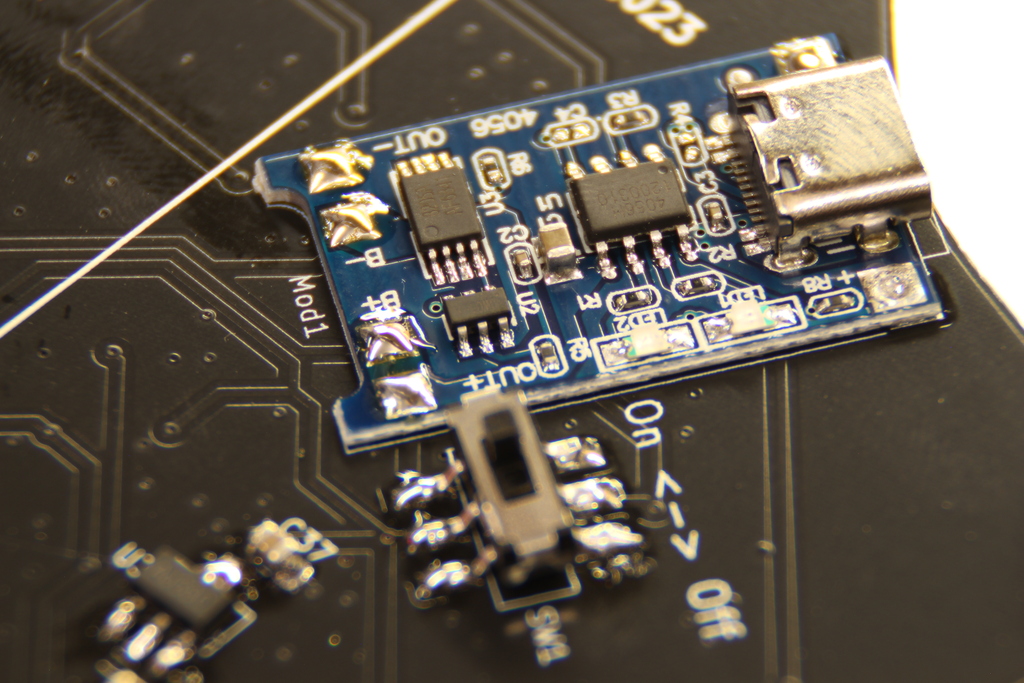
[picture p57: Doku/Bilder/IMG_8477.JPG]


### Ladebuchse - J2

Die Ladebuchse ist ein THT-Bauteil, es muss von oben in die Platine gsteckt, aber von der Unterseite verlötet werden.

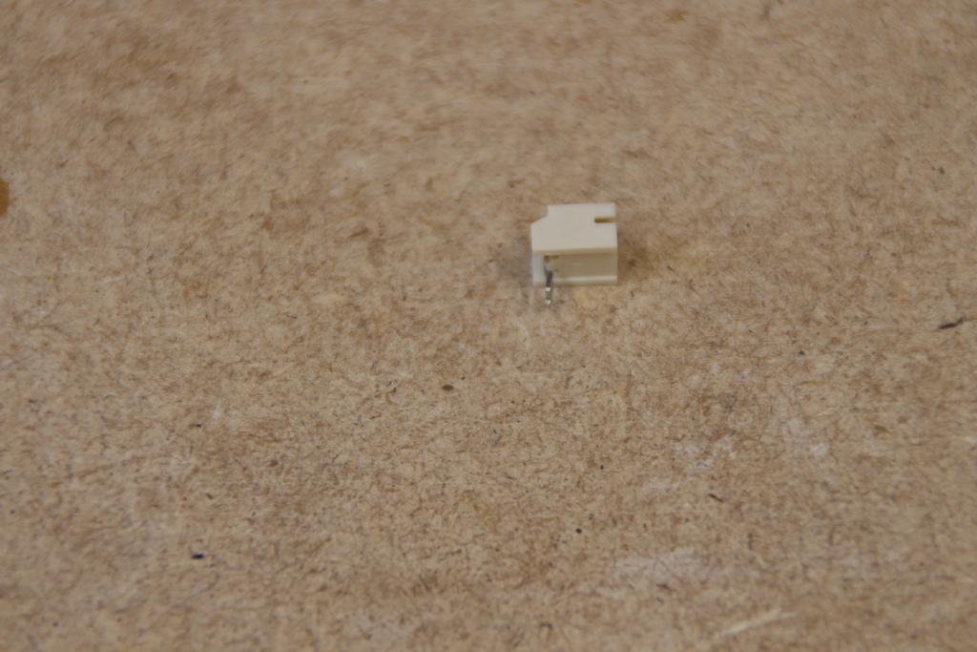
[picture p58: Doku/Bilder/IMG_8437.JPG]


Das heißt die Platine muss jetzt aus den PCBites gelöst werden und andersherum wieder eingespannt werden. Die Buchse sollte von alleine halten, wenn sie doch herausfällt, muss sie mit einem Finger leicht fixiert werden.

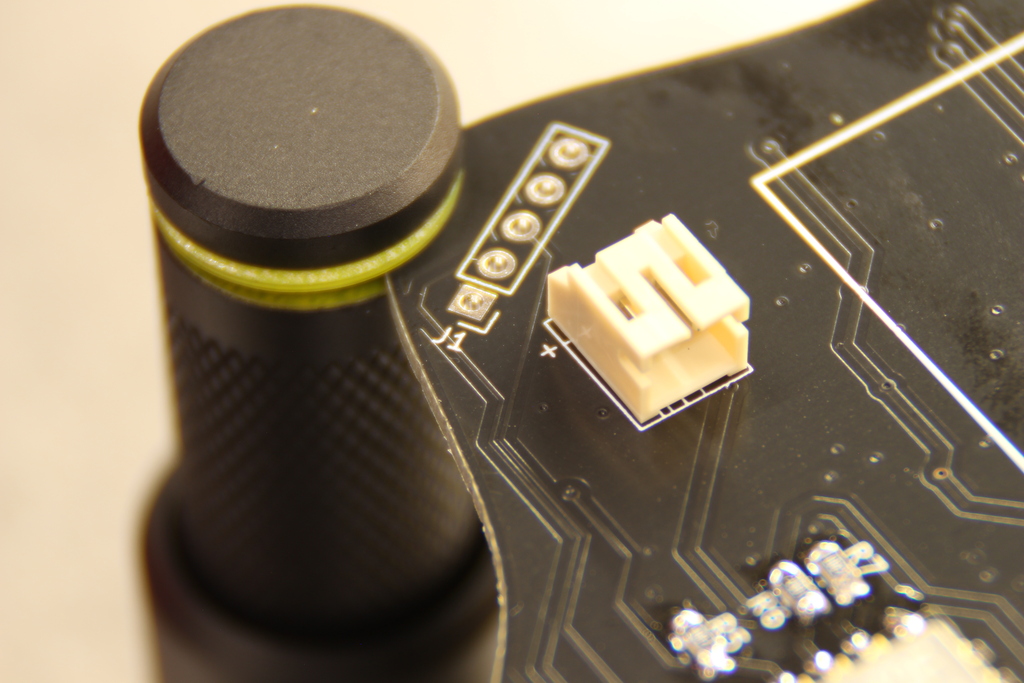
[picture p59: Doku/Bilder/IMG_8478.JPG]


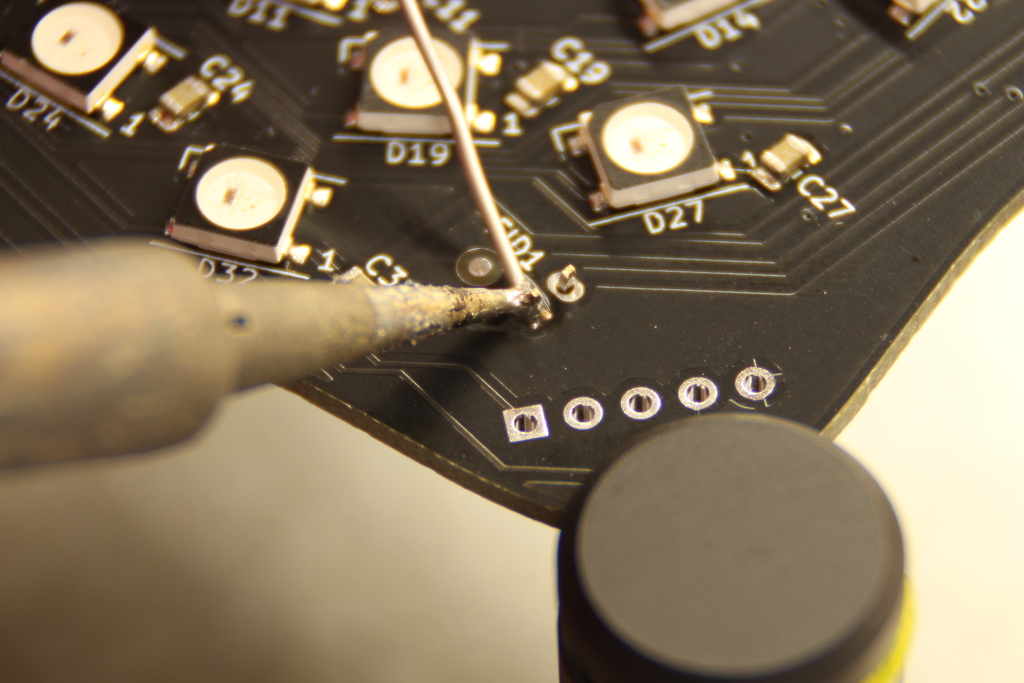
[picture p60: Doku/Bilder/IMG_8479.JPG]


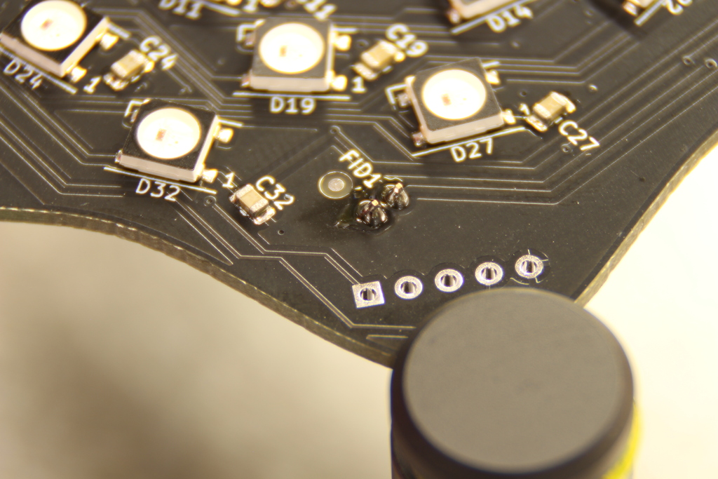
[picture p61: Doku/Bilder/IMG_8480.JPG]


### Taster - ohne Namen

Der Taster war im ursprünglichen Design nicht vorgesehen. Weil er aber so praktisch ist, wird er an der Stelle reingefuddelt, wo die optionale Programmierschnittstelle hätte hinkommen können.

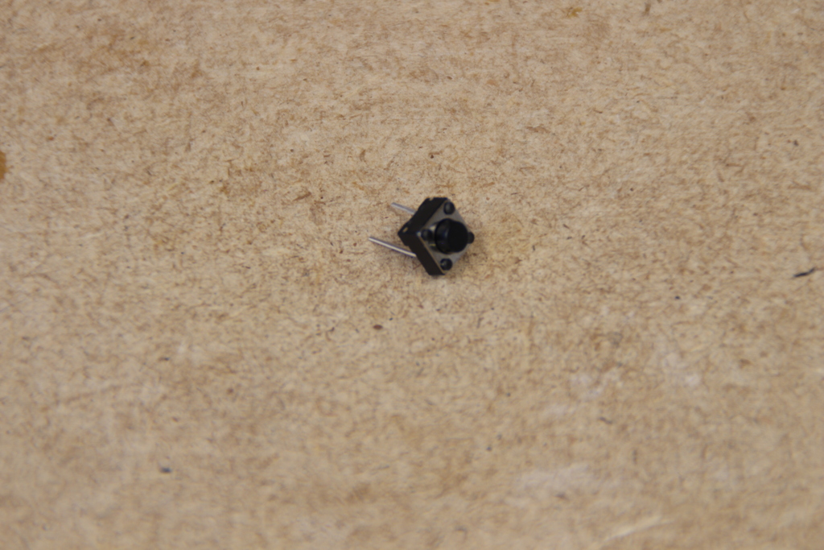
[picture p62: Doku/Bilder/IMG_8438.JPG]


Die Platine kann auf dem Kopf bleiben und der Taster muss von unten durchgefädelt werden.

Die Beinchen müssen durch zwei Bohrungen von J1 gesteckt werden. Vorgesehen sind dafür die mittlere Bohrung und die, die am weitesten von der Bohrung mit dem quadratischen Pad entfernt ist.
Schematisch:

|[ ]| O| O| O| O|
|-|-|-|-|-|
| | |x | | x |

Damit der Taster beim Verlöten nicht herausfällt, können die Beinchen verbogen werden.

Beim Verlöten des ersten Beinchens sollte der Taster trotzdem mit einem Finger fixiert werden, damit er anschließend ordentlich auf der Platine aufliegt.

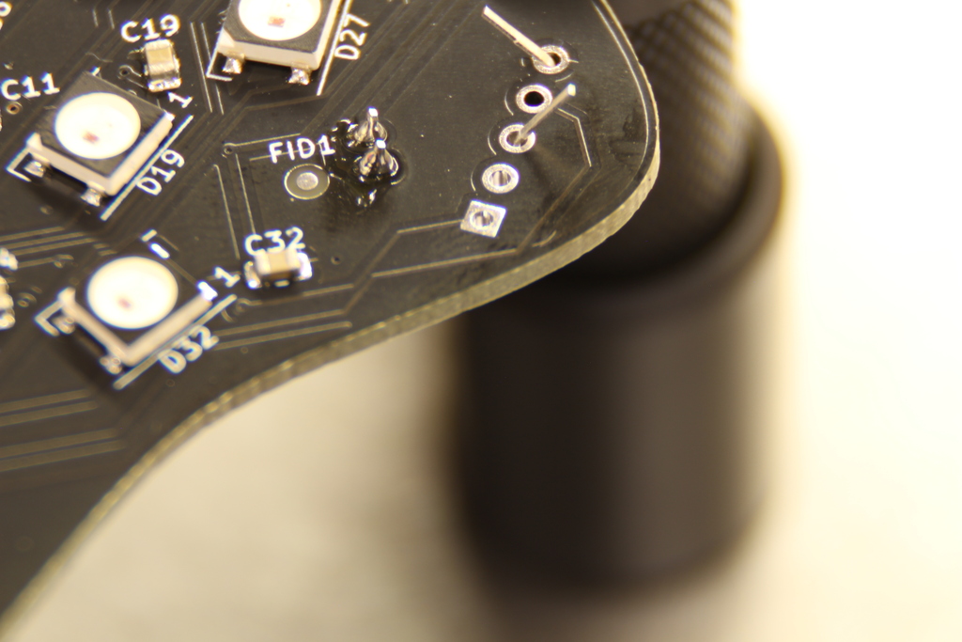
[picture p63: Doku/Bilder/IMG_8482.JPG]


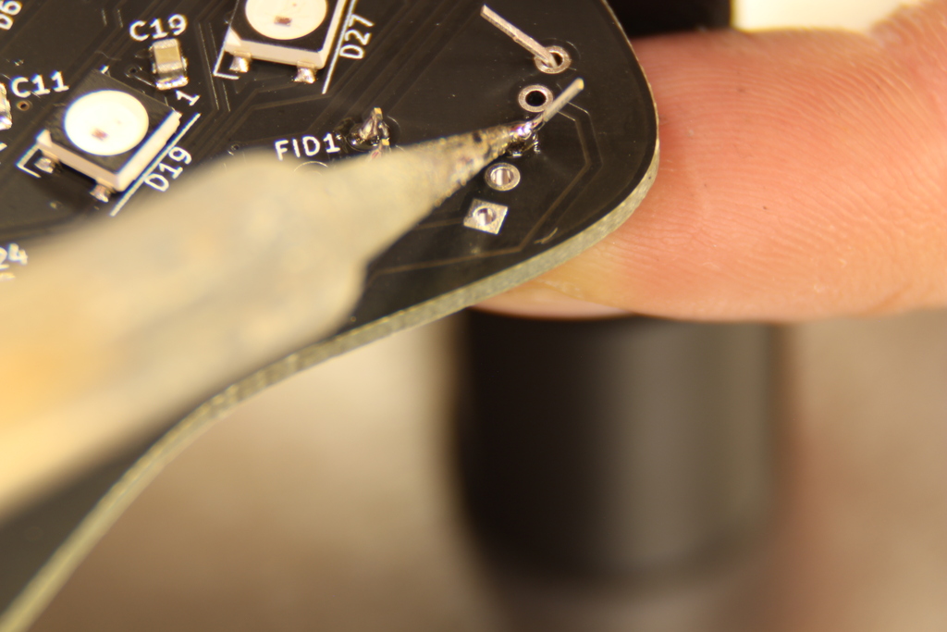
[picture p64: Doku/Bilder/IMG_8483.JPG]


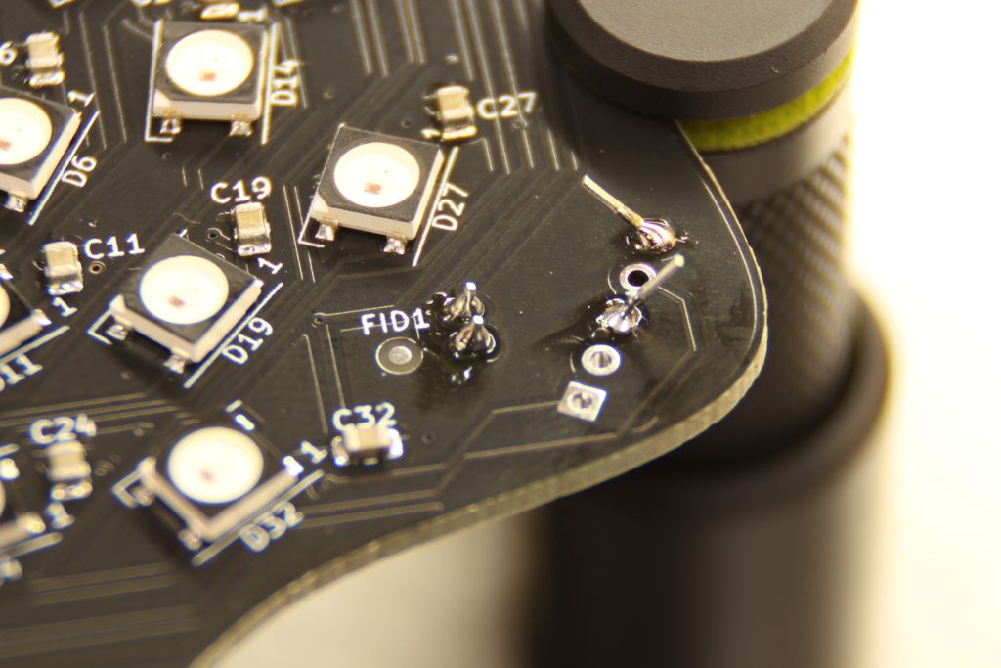
[picture p65: Doku/Bilder/IMG_8484.JPG]


Nach dem Verlöten müssen die Beinchen noch gekürzt werden.

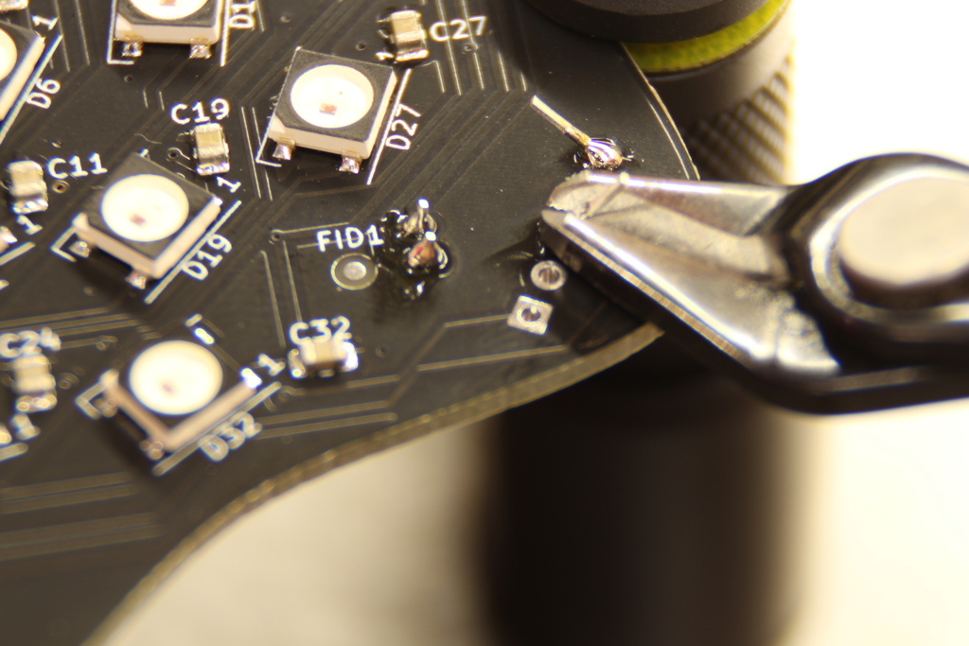
[picture p66: Doku/Bilder/IMG_8485.JPG]


### Akku

Der Akku wird mit Klettverschluss an der Platine fixiert. Dazu muss die Platine aus den PCBites gelöst werden.

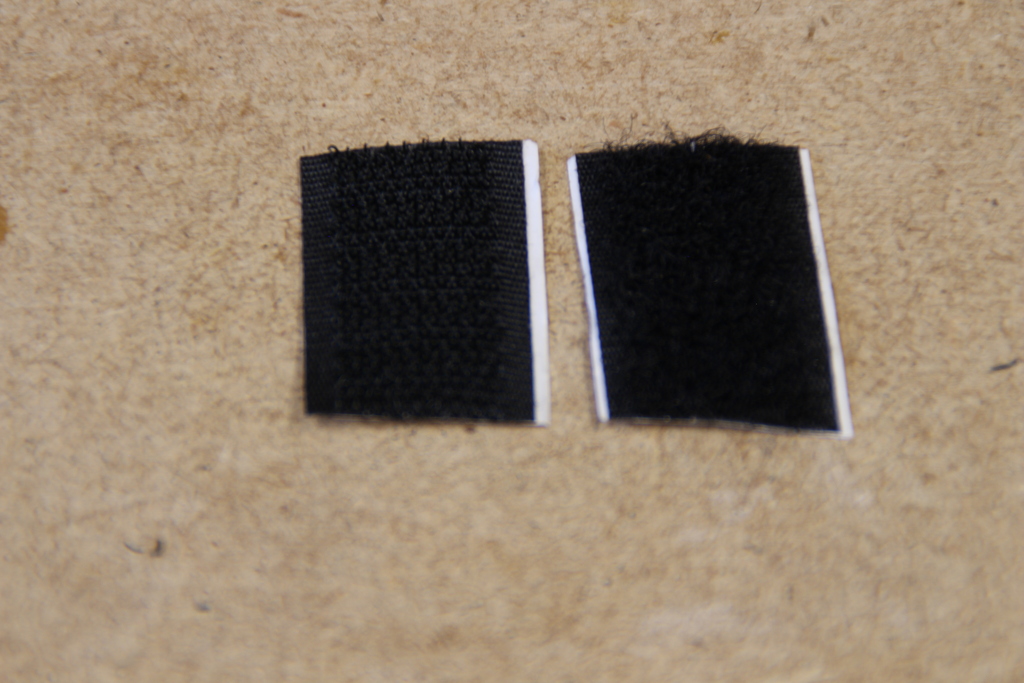
[picture p67: Doku/Bilder/IMG_8439.JPG]


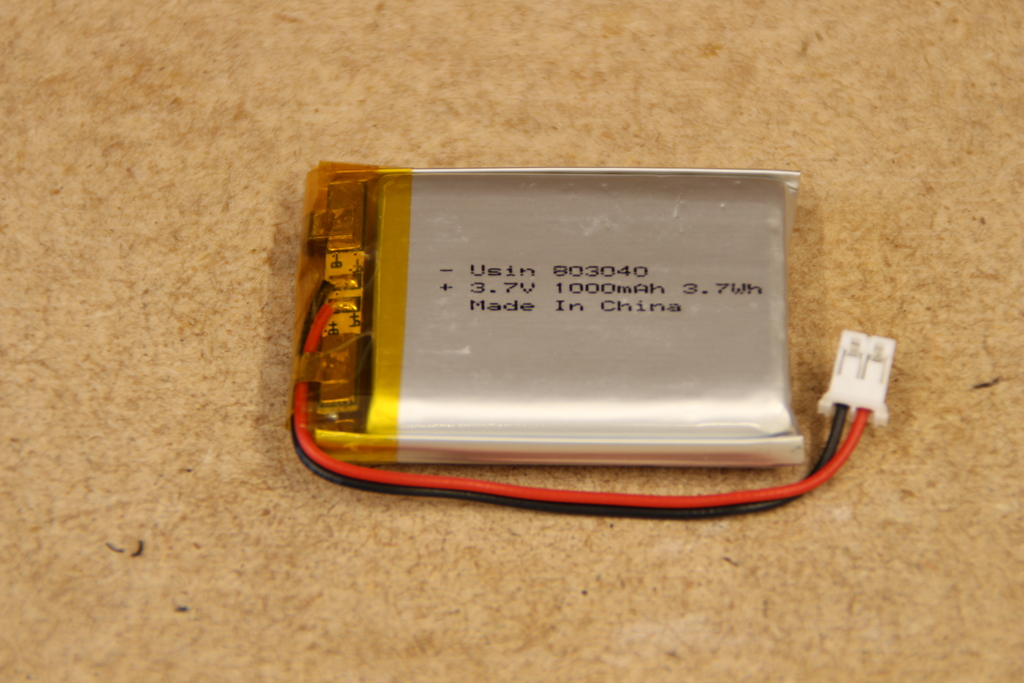
[picture p68: Doku/Bilder/IMG_8440.JPG]


Zuerst wird der **flauschige** Teil des Klettverschlusses auf den Akku geklebt.

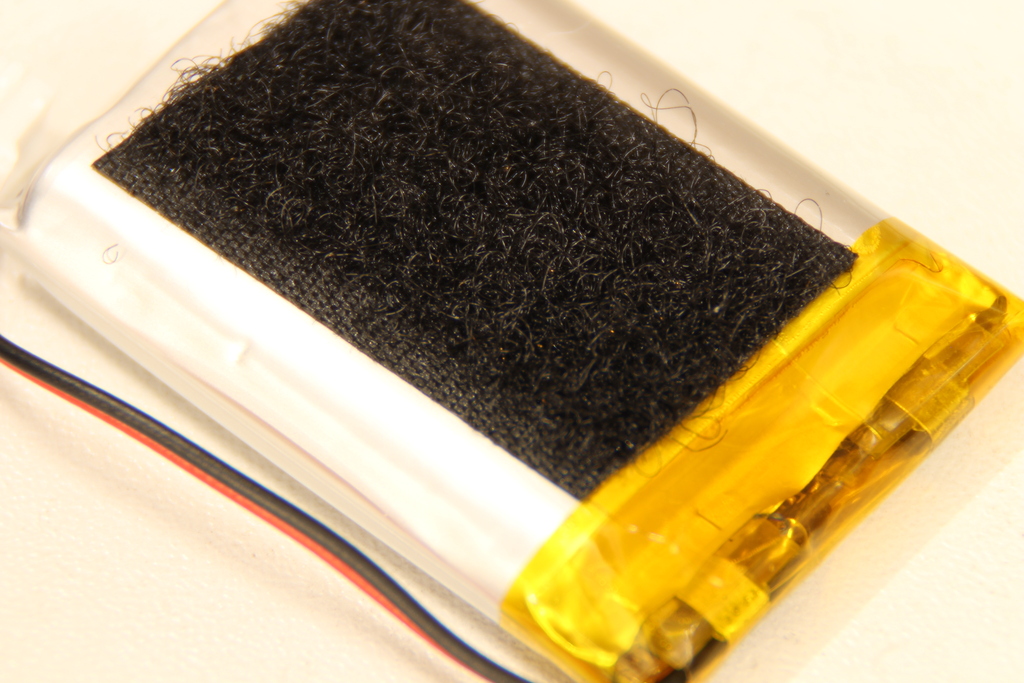
[picture p69: Doku/Bilder/IMG_8487.JPG]


Anschließend wird der andere Teil mit dem flauschigen Teil verbunden und die Schutzfolie vom Klebeband entfernt.

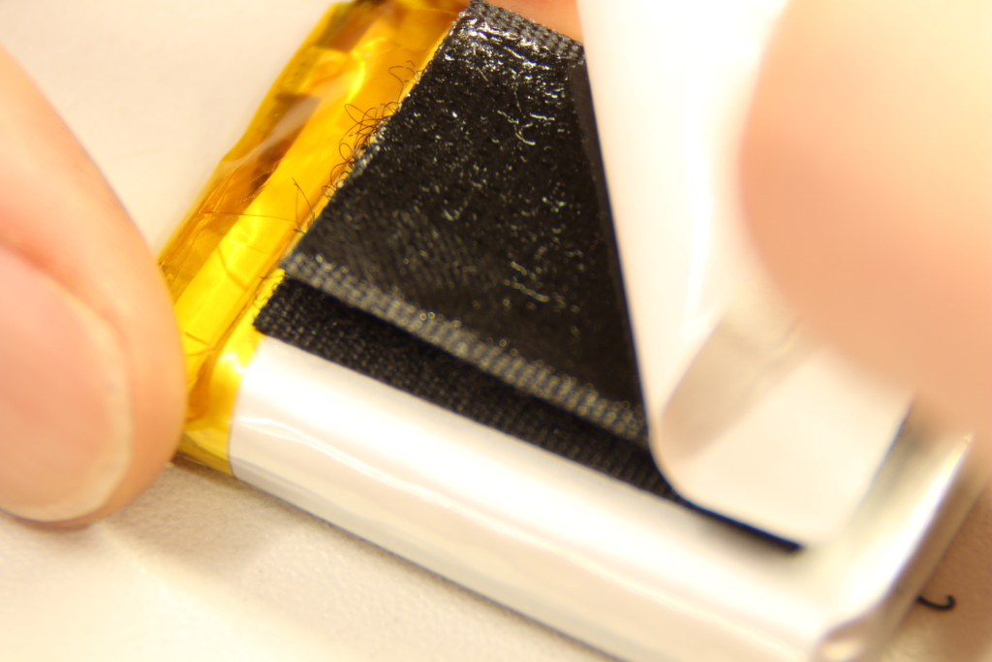
[picture p70: Doku/Bilder/IMG_8488.JPG]


Jetzt wird der Akku mittig in das weiße Rechteck geklebt.

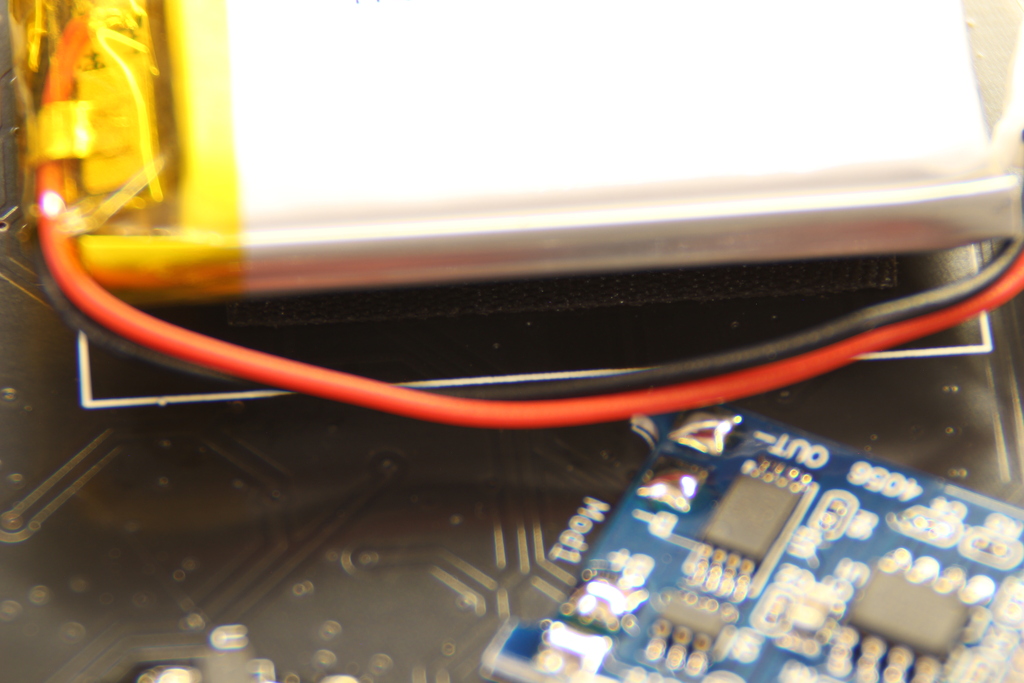
[picture p71: Doku/Bilder/IMG_8489.JPG]


Zu guter Letzt wird der Stecker des Akkus in die Buchse J2 gesteckt.

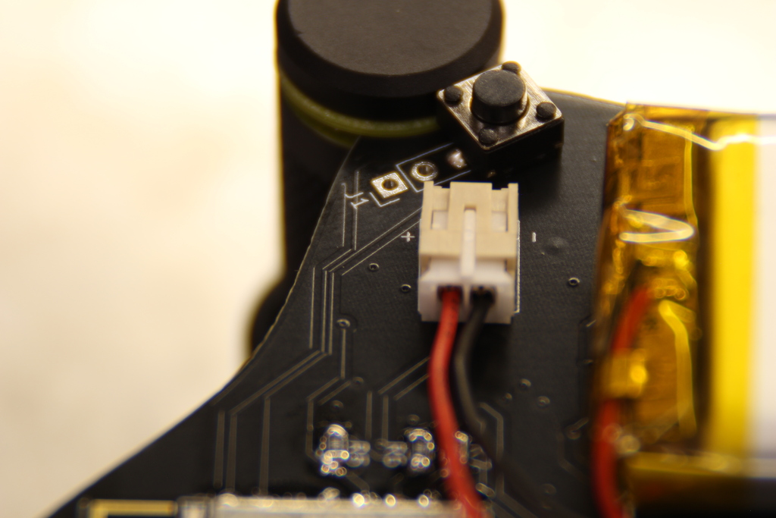
[picture p72: Doku/Bilder/IMG_8490.JPG]


Wenn der Schalter auf **On** gestellt ist, sollte die Platine nun irgendwie leuchten.

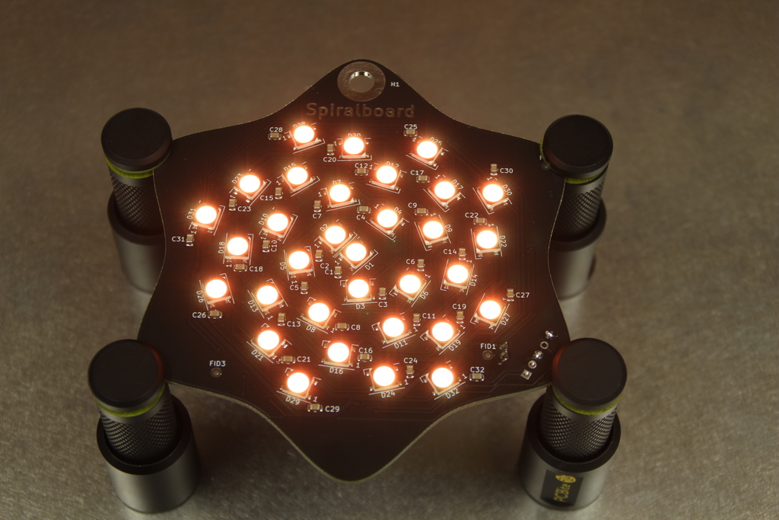
[picture p73: Doku/Bilder/IMG_8492.JPG]


## Schritt 4: WLED

Auf dem Controller ist die Open Source Firmware "WLED", mit ein paar von uns konfigurierten Presets, installiert.

Auf dem Smartphone sollte ein WLAN-Access-Point zu sehen sein, der sich aus **Spiralboard-** und der Nummer auf dem ESP8266-Modul zusammensetzt. Das default Passwort ist **wled1234**.

Über die Website die sich öffnet, wenn eine Verbindung zu diesem Access-Point aufgebaut wird, kann die Anzeige auf dem Spiralboard gesteuert werden.

Die vorinstallierten Presets lassen sich durch einfachen Klick des Tasters umschalten und durch langen Klick schaltest du das Board in einen automatischen Wechselzyklus bei dem es alle 10 Sekunden das Preset wechselt.

Weitere Infos zu WLED gibt es hier: https://kno.wled.ge/

Du kannst das Board über WLED frei konfigurieren, updaten usw...
Wir empfehlen dir, das Board Zuhause mit deinem Heimnetzwerk zu verbinden, da es sich dann viel leichter konfigurieren lässt.

Wir wünschen dir viel Spaß mit deinem eigenen Spiralboard und hoffen es hat dir Spaß gemacht!
