casartar/Spiralboard/AssortmentBox/Spiralboard-Assortment.pdf

32x 100nF | 32x WS2812B | Bottom -> | 3x 10µF | 2x 100nF | 5x 10kΩ
1x 10kΩ | | | 1x ESP-12F | 1x SOT-89-3 | 1x MSS22D18G2
1x LiPo Charger | THT -> | Taster in Pin 3 & 5 von J1 | 1x JST_PH_S2B | Sonstiges -> | 1x Klett

# Spiralboard
