casartar/Spiralboard/MISC/Plakat/gpn_this_way_left.pdf

This | Way | to
Hackcenter | High

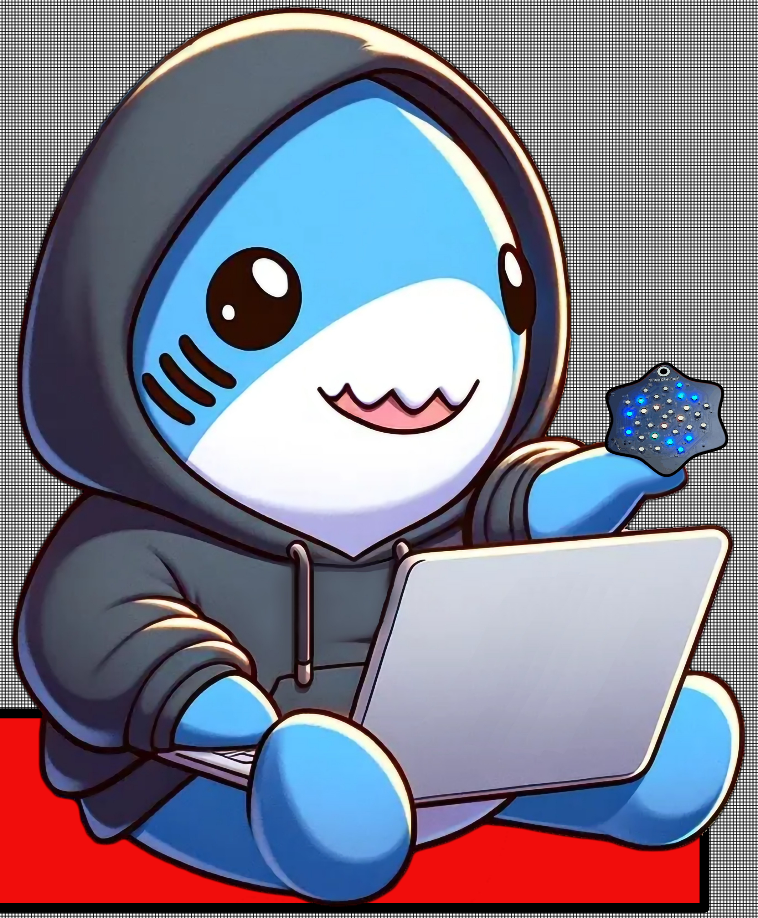
[picture p75: figure]

Build | your | own
spiralBoard
