casartar/Spiralboard/MISC/Plakat/gpn_this_way_right.pdf

This | Way | to
Hackcenter | High

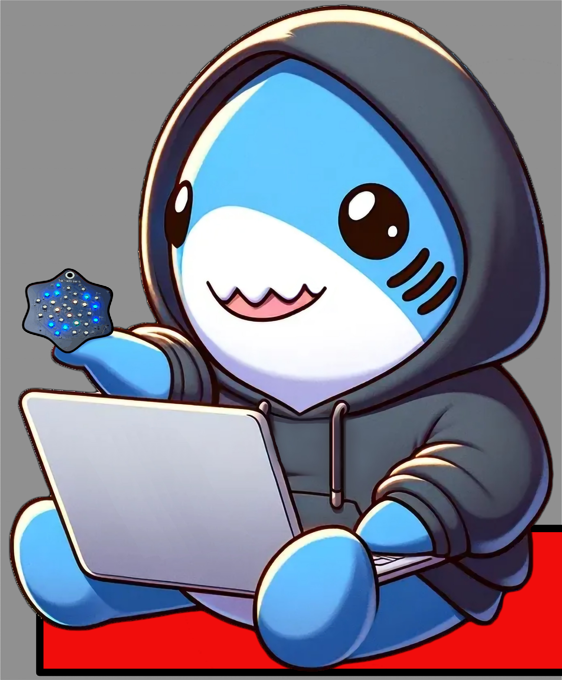
[picture p76: figure]

Build | your | own
spiralBoard
