casartar/Spiralboard/MISC/Plakat/gpn_this_way_up_left.pdf

This | Way | to
Hackcenter | High

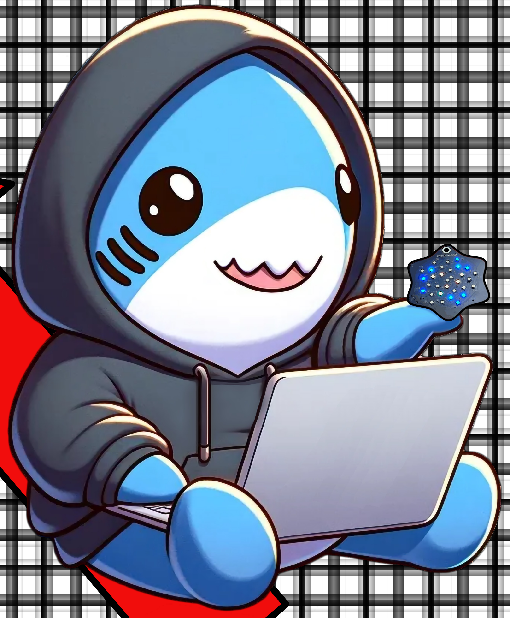
[picture p77: figure]

Build | your | own
spiralBoard
