casartar/Spiralboard/MISC/Plakat/gpn_this_way_up_right.pdf

This | Way | to
Hackcenter | High

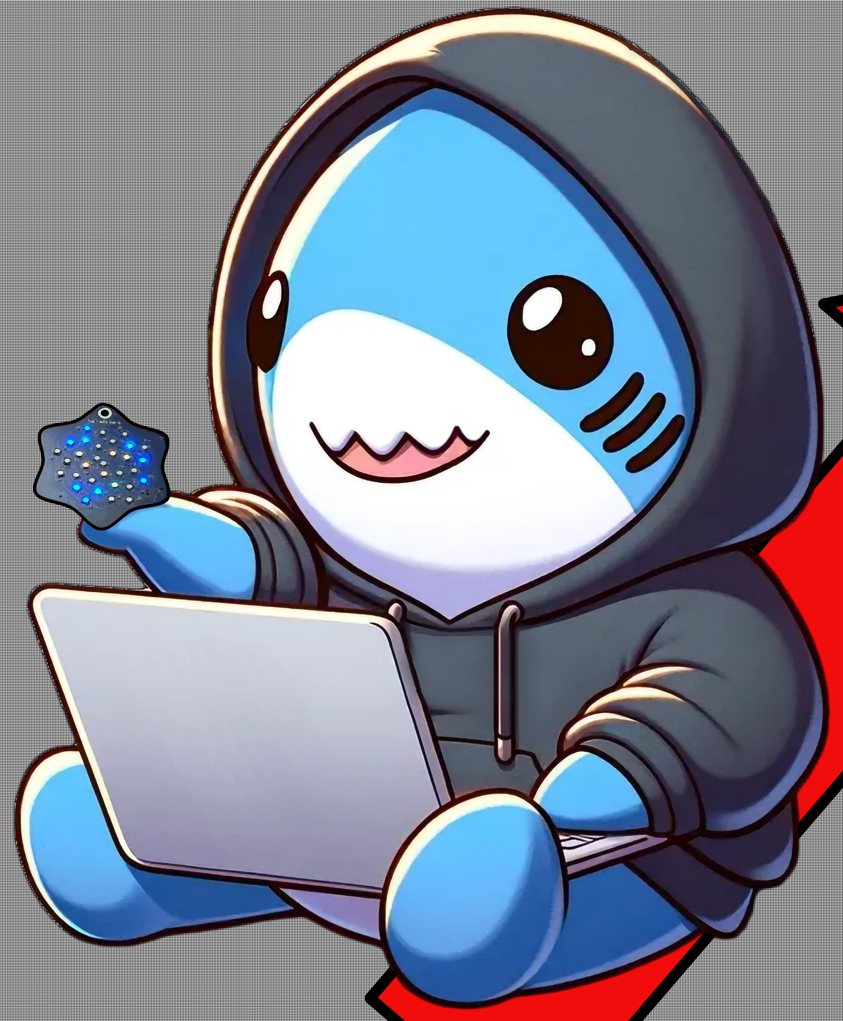
[picture p78: figure]

Build | your | own
spiralBoard
