casartar/Spiralboard/MISC/Hände Waschen/Canning.pdf

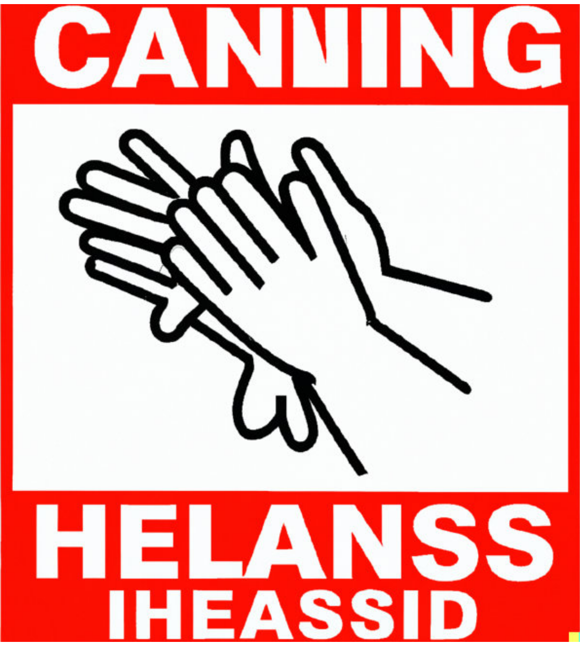
[picture p79: page 1]
