casartar/Spiralboard/MISC/Hände Waschen/Claution.pdf

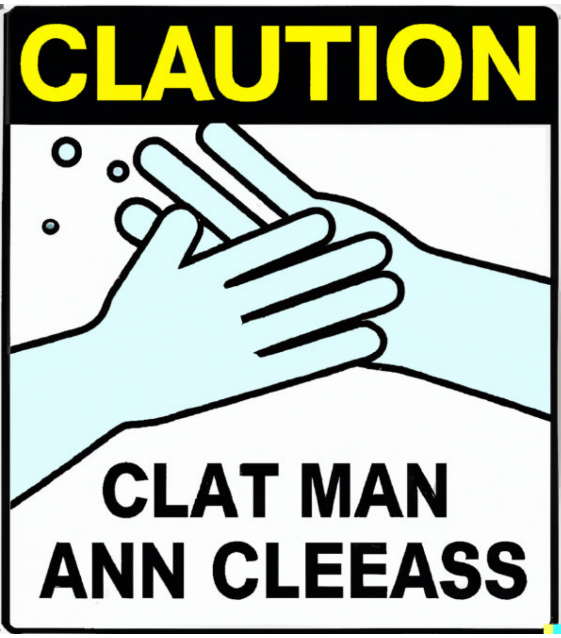
[picture p80: page 1]
