casartar/Spiralboard/MISC/Hände Waschen/Cleansh Cleanses.pdf

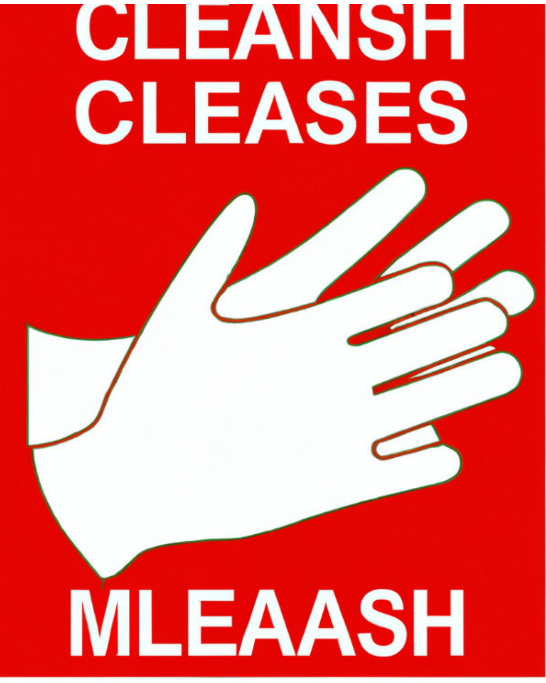
[picture p81: page 1]
