casartar/Spiralboard/Doku/Bilder/IMG_8404.JPG

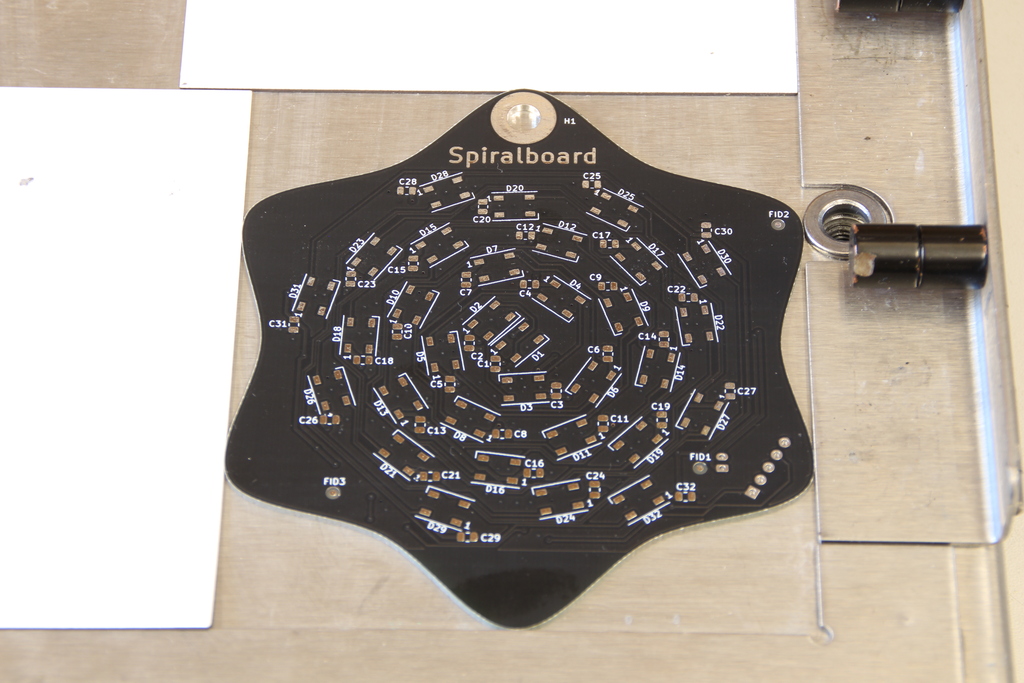
Doku/Bilder/IMG_8404.JPG
