casartar/Spiralboard/Doku/Bilder/IMG_8406.JPG

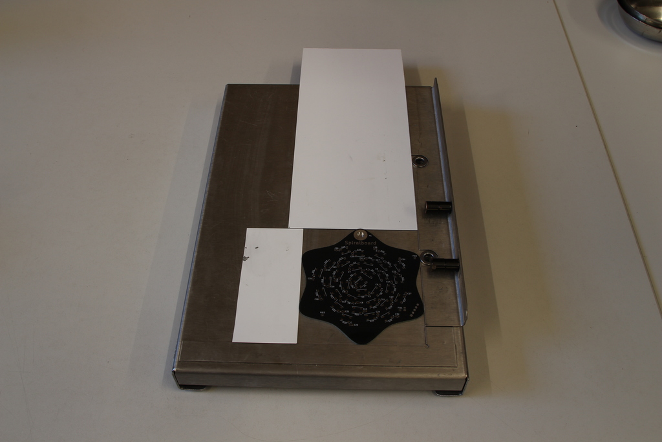
Doku/Bilder/IMG_8406.JPG
