casartar/Spiralboard/Doku/Bilder/IMG_8407.JPG

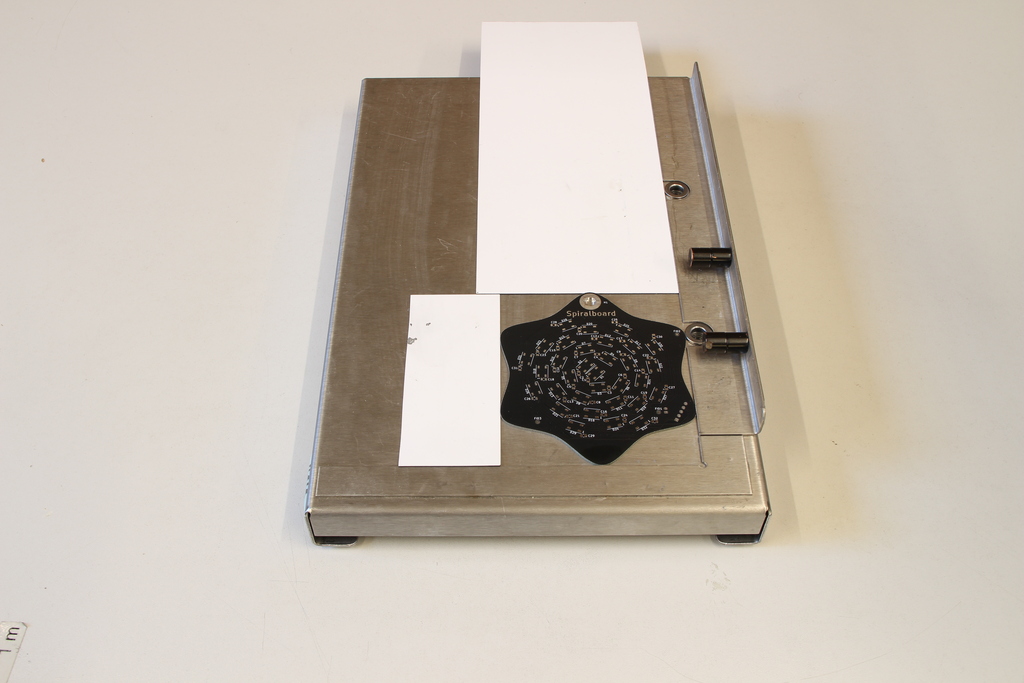
Doku/Bilder/IMG_8407.JPG
