casartar/Spiralboard/Doku/Bilder/IMG_8426.JPG

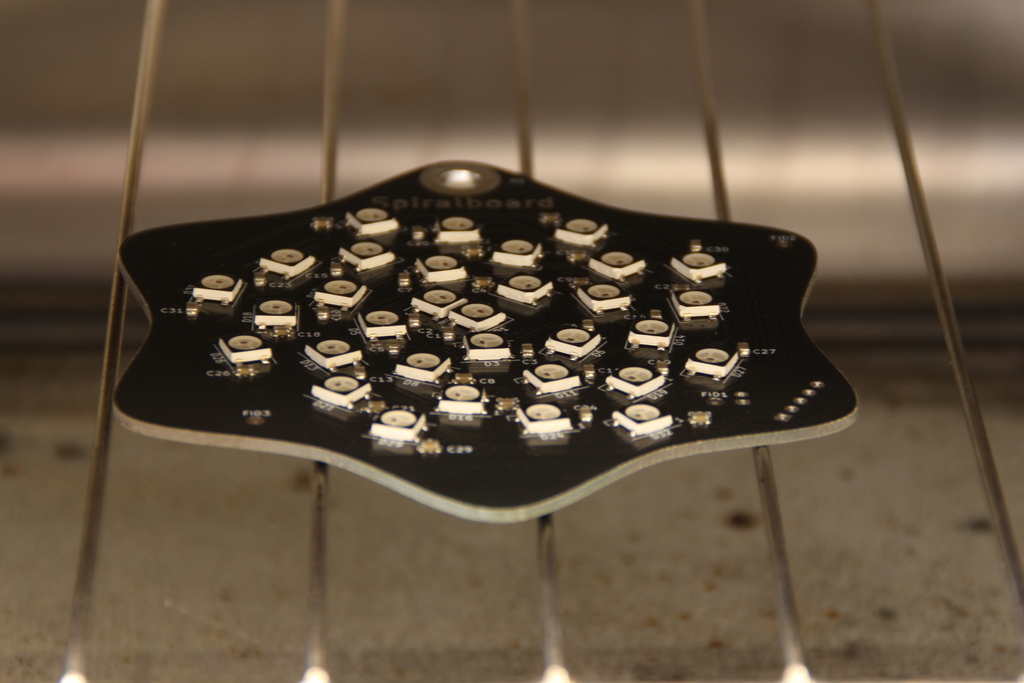
Doku/Bilder/IMG_8426.JPG
