casartar/Spiralboard/Doku/Bilder/IMG_8428.JPG

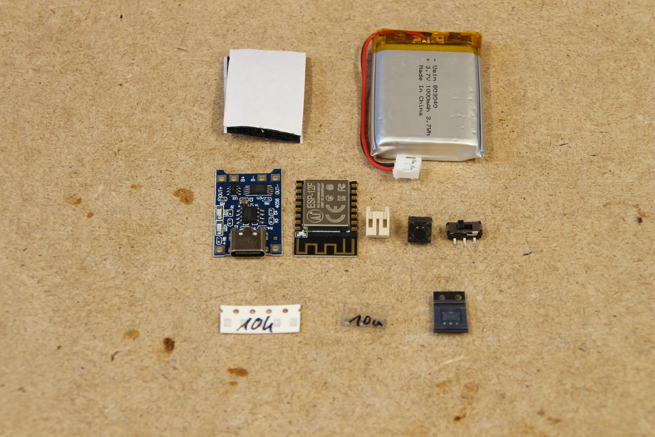
Doku/Bilder/IMG_8428.JPG
