casartar/Spiralboard/Doku/Bilder/IMG_8429.JPG

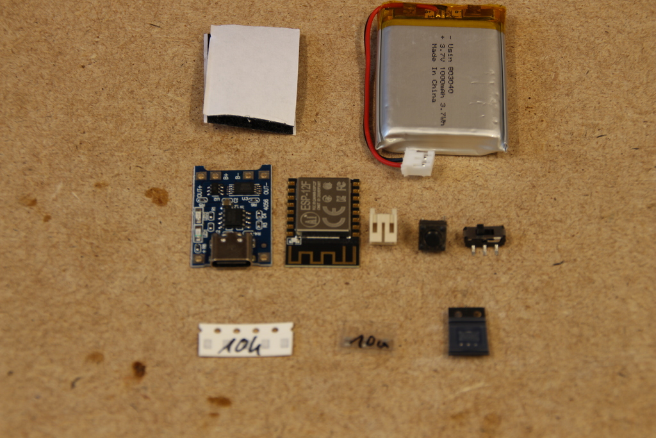
Doku/Bilder/IMG_8429.JPG
