casartar/Spiralboard/Doku/Bilder/IMG_8430.JPG

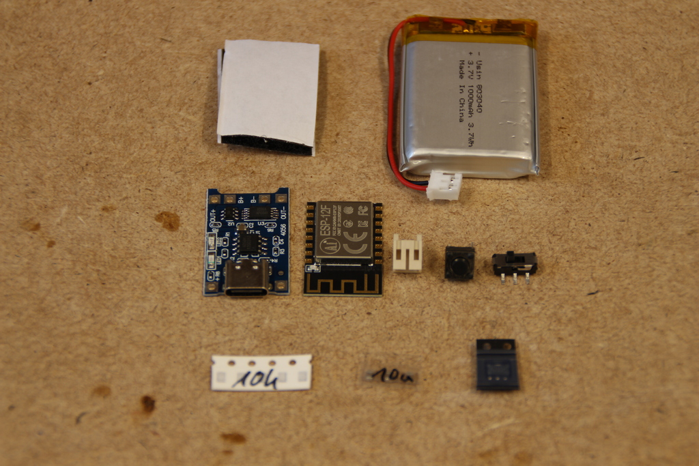
Doku/Bilder/IMG_8430.JPG
