casartar/Spiralboard/Doku/Bilder/IMG_8442.JPG

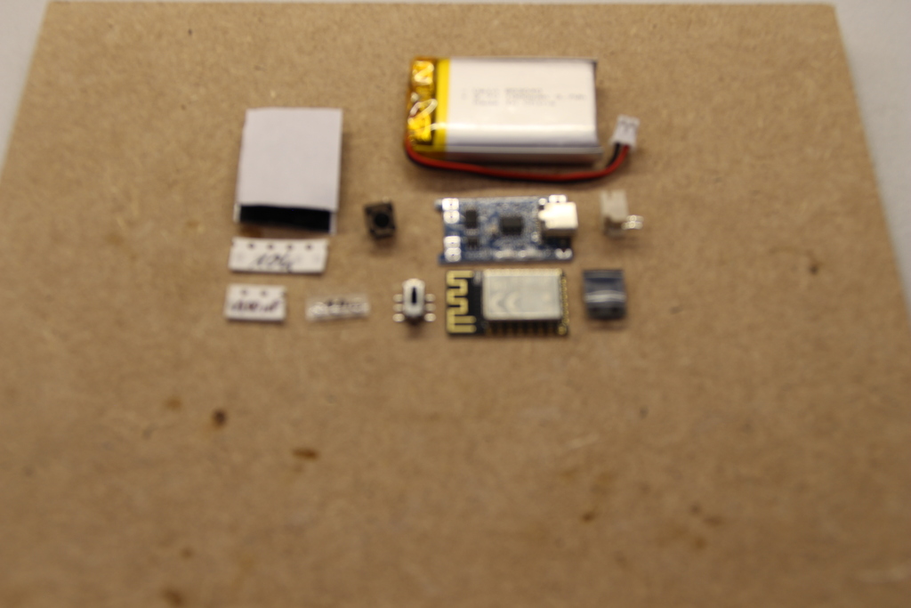
Doku/Bilder/IMG_8442.JPG
