casartar/Spiralboard/Doku/Bilder/IMG_8445.JPG

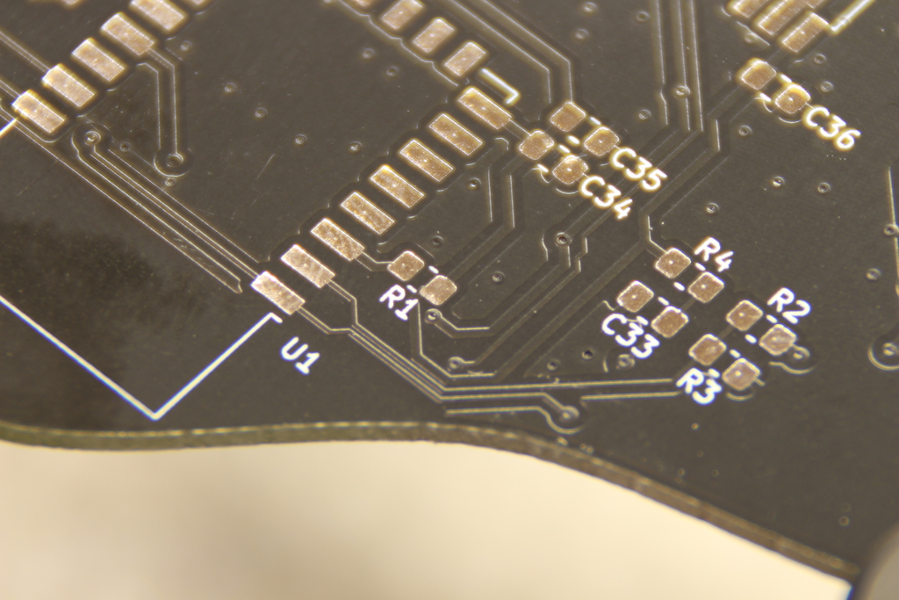
Doku/Bilder/IMG_8445.JPG
