casartar/Spiralboard/Doku/Bilder/IMG_8448.JPG

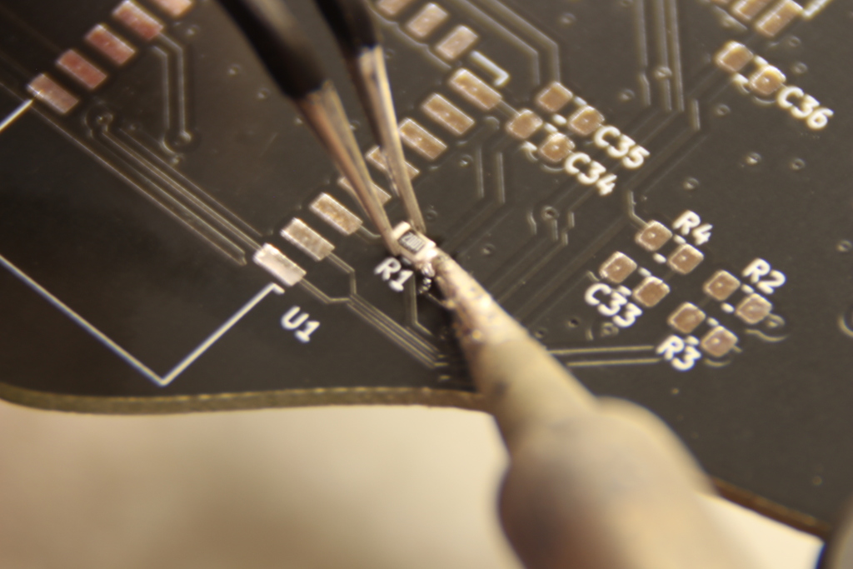
Doku/Bilder/IMG_8448.JPG
