casartar/Spiralboard/Doku/Bilder/IMG_8454.JPG

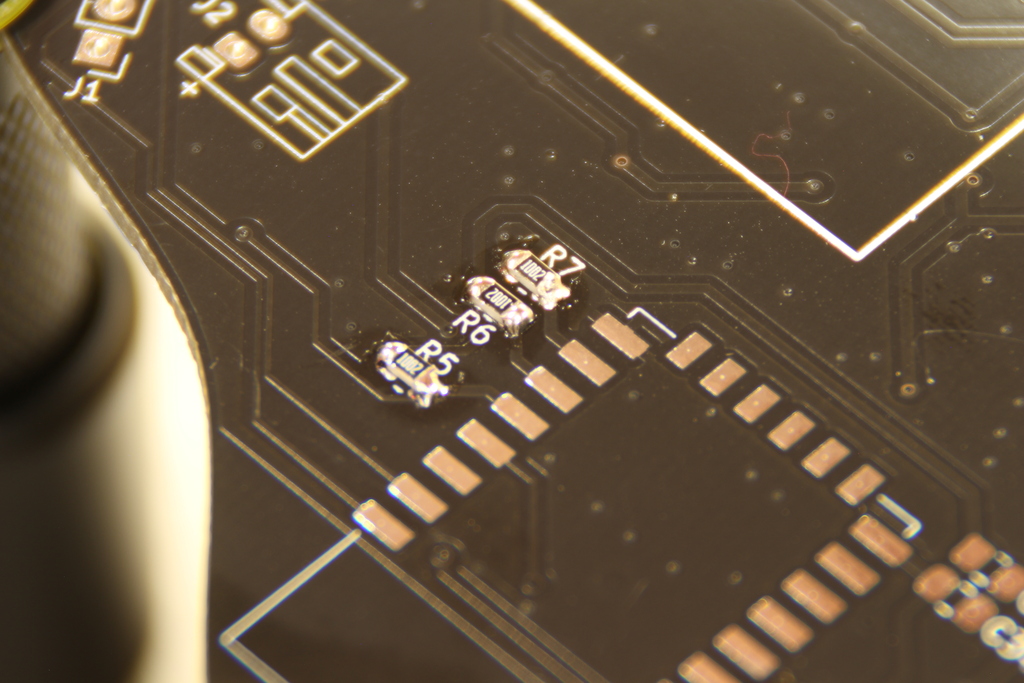
Doku/Bilder/IMG_8454.JPG
