casartar/Spiralboard/Doku/Bilder/IMG_8466.JPG

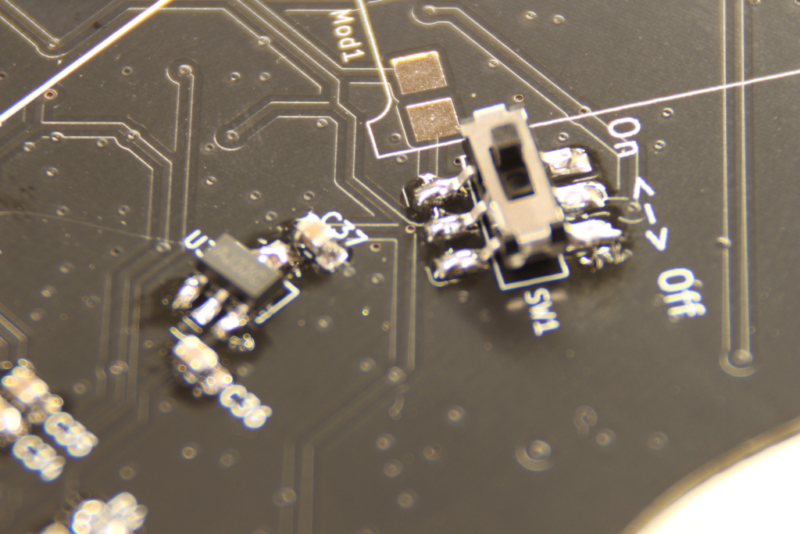
Doku/Bilder/IMG_8466.JPG
