casartar/Spiralboard/Doku/Bilder/IMG_8472.JPG

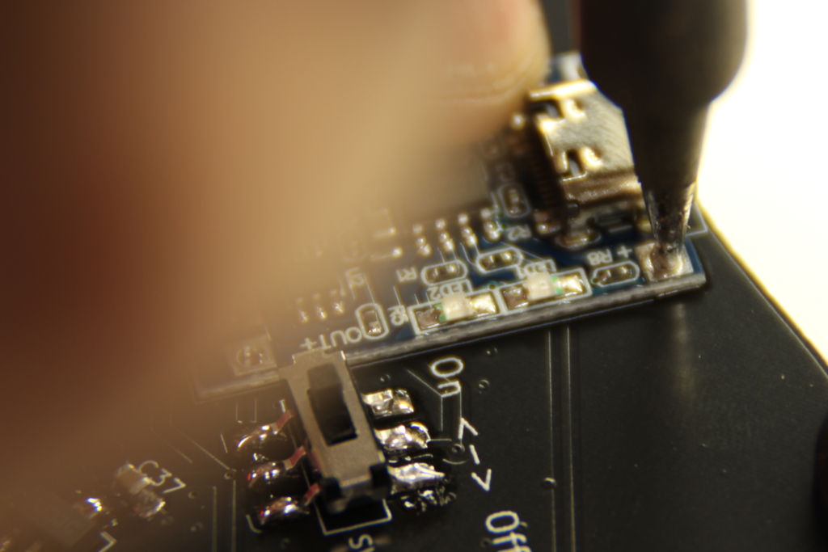
Doku/Bilder/IMG_8472.JPG
