casartar/Spiralboard/Doku/Bilder/IMG_8473.JPG

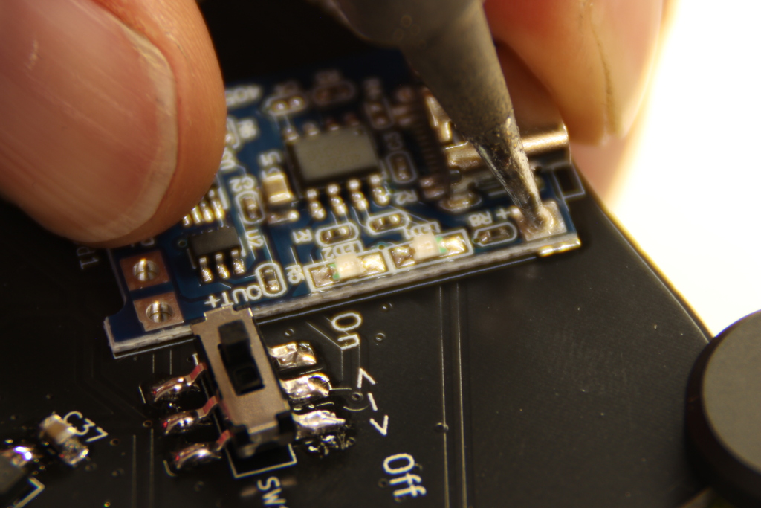
Doku/Bilder/IMG_8473.JPG
