casartar/Spiralboard/Doku/Bilder/IMG_8476.JPG

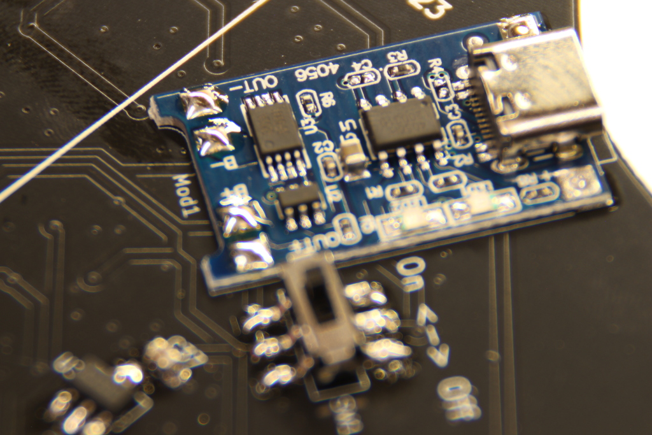
Doku/Bilder/IMG_8476.JPG
