casartar/Spiralboard/Doku/Bilder/IMG_8481.JPG

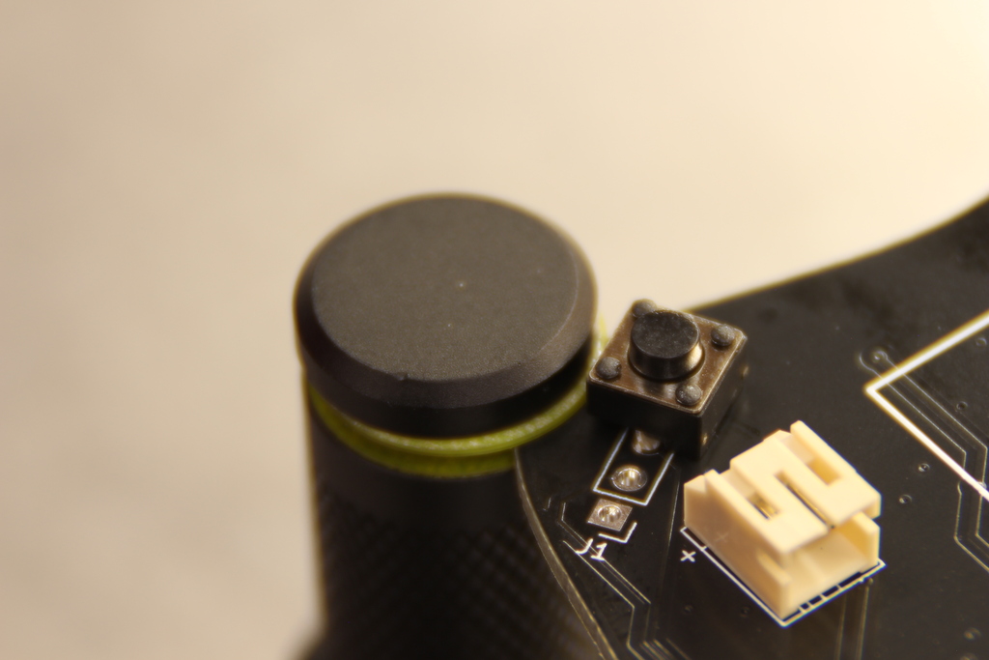
Doku/Bilder/IMG_8481.JPG
