casartar/Spiralboard/Doku/Bilder/IMG_8486.JPG

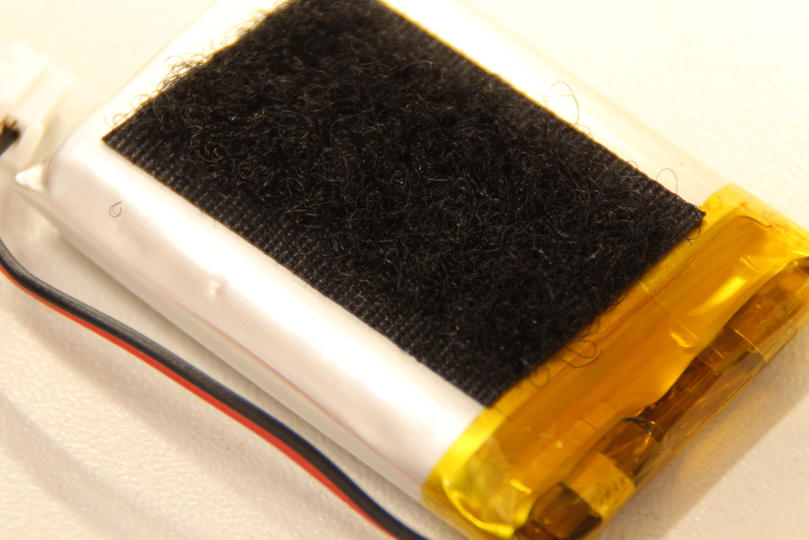
Doku/Bilder/IMG_8486.JPG
