casartar/Spiralboard/Doku/Bilder/IMG_8491.JPG

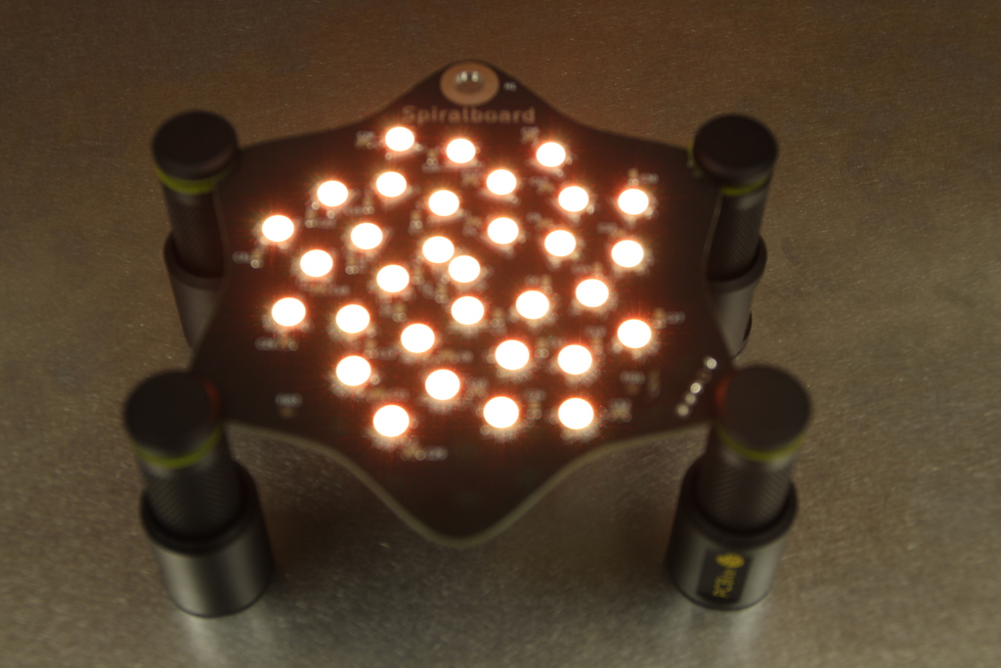
Doku/Bilder/IMG_8491.JPG
