casartar/Spiralboard/Doku/Screenshots/C_10µ.png

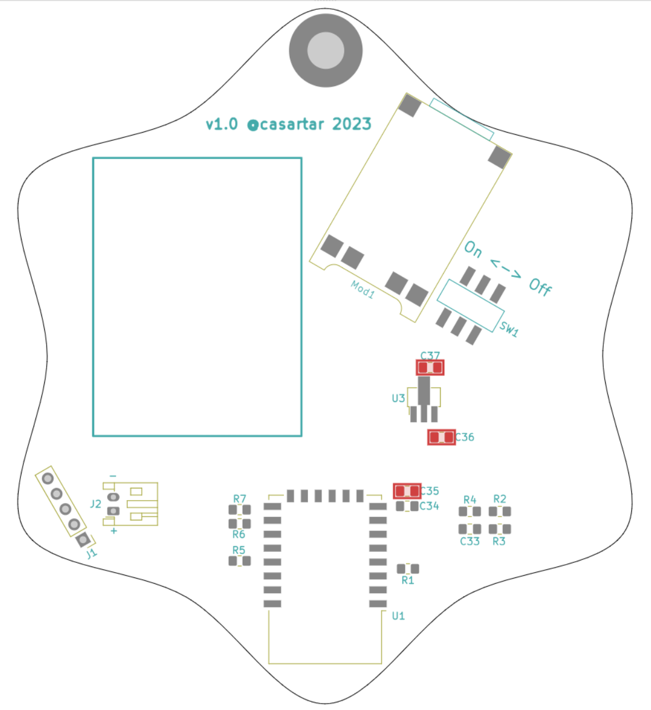
Doku/Screenshots/C_10µ.png
