casartar/Spiralboard/Doku/Screenshots/ESP-12e.png

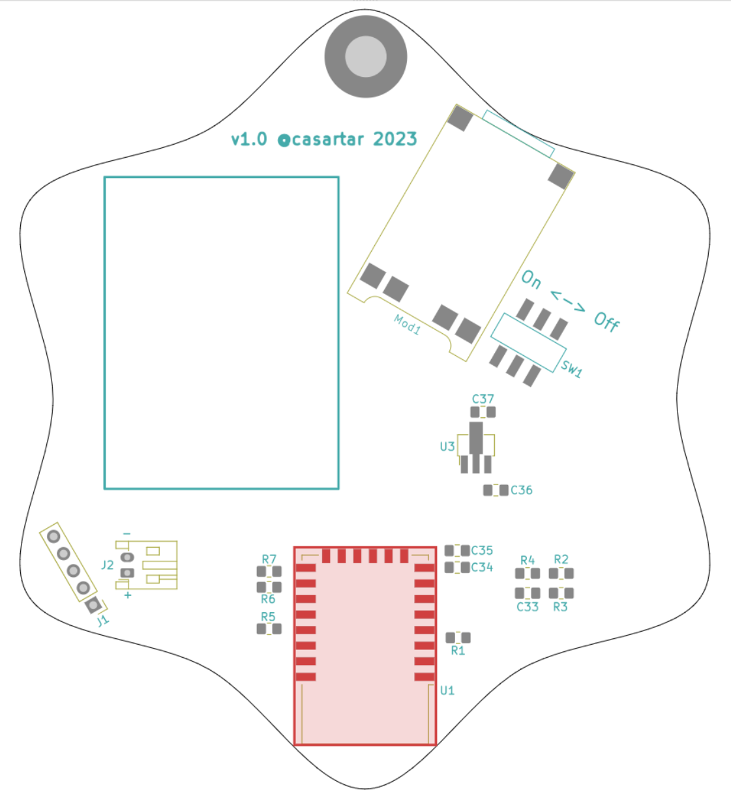
Doku/Screenshots/ESP-12e.png
