casartar/Spiralboard/Housing/spiralboard.step

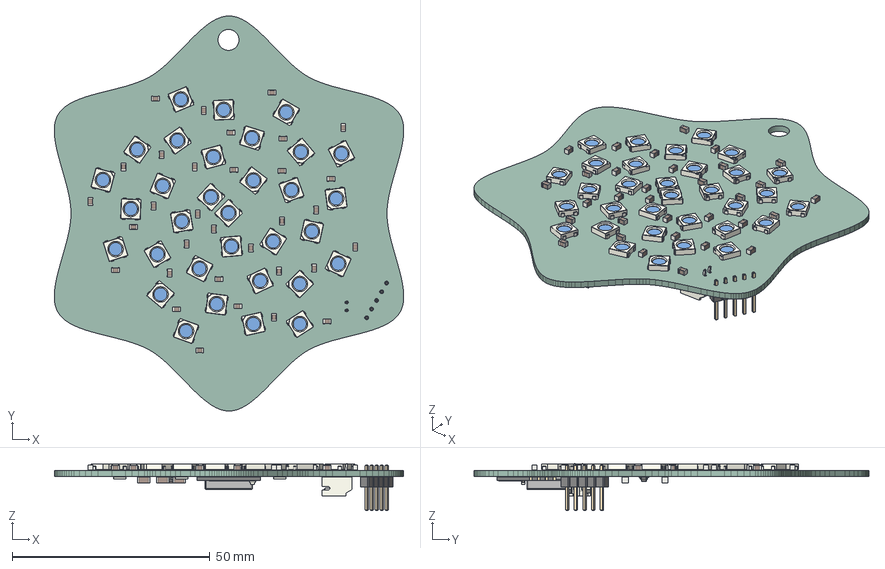
[picture p102: CAD file, 2026-01-02]
Housing/spiralboard.step
88.5 x 100.0 x 11.9 mm
C_0805_2012Metric x 32
LED_WS2812B_PLCC4_50x50mm_P32mm x 32
C_1206_3216Metric x 5
R_1206_3216Metric x 7
SOT_23
JST_S2B_PH_K
ESP_12E001_cp
PinHeader_1x05_P254mm_Vertical
spiralboard_PCB
