casartar/Spiralboard/Housing/spiral_board_outline2.dxf

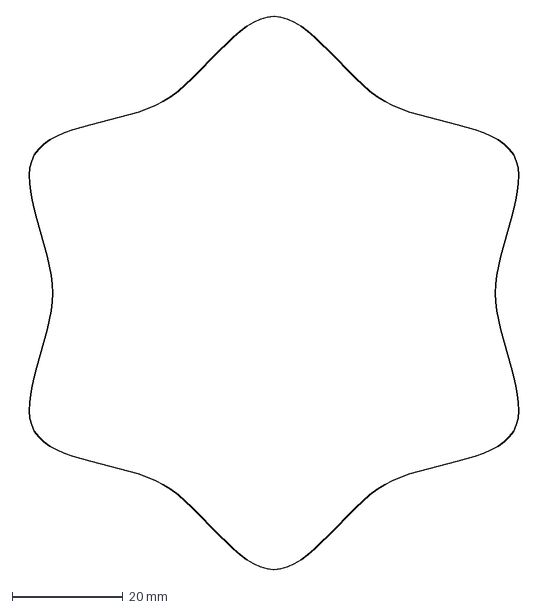
[picture p103: CAD file, 2026-01-02]
Housing/spiral_board_outline2.dxf
93.3 x 100.0 mm
