casartar/Spiralboard/PCB/spiralboard.pdf

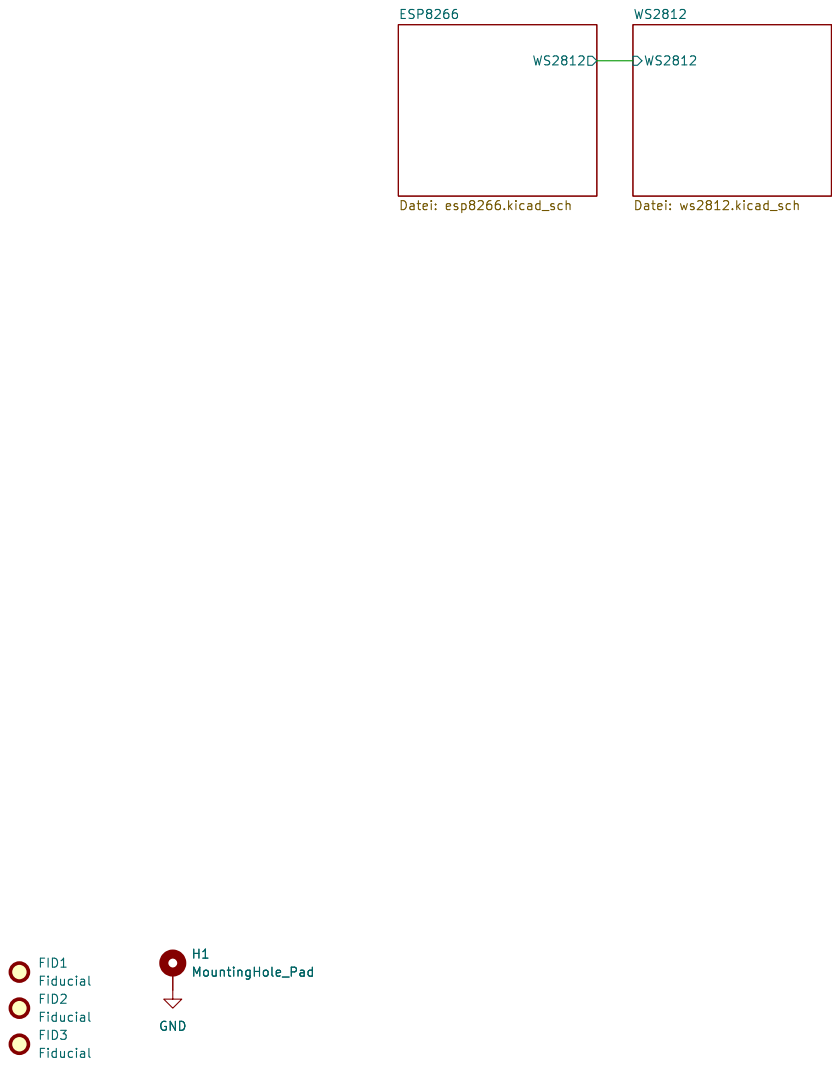
[picture p104: page 1]

File: spiralboard.kicad_sch Sheet: / @casartar

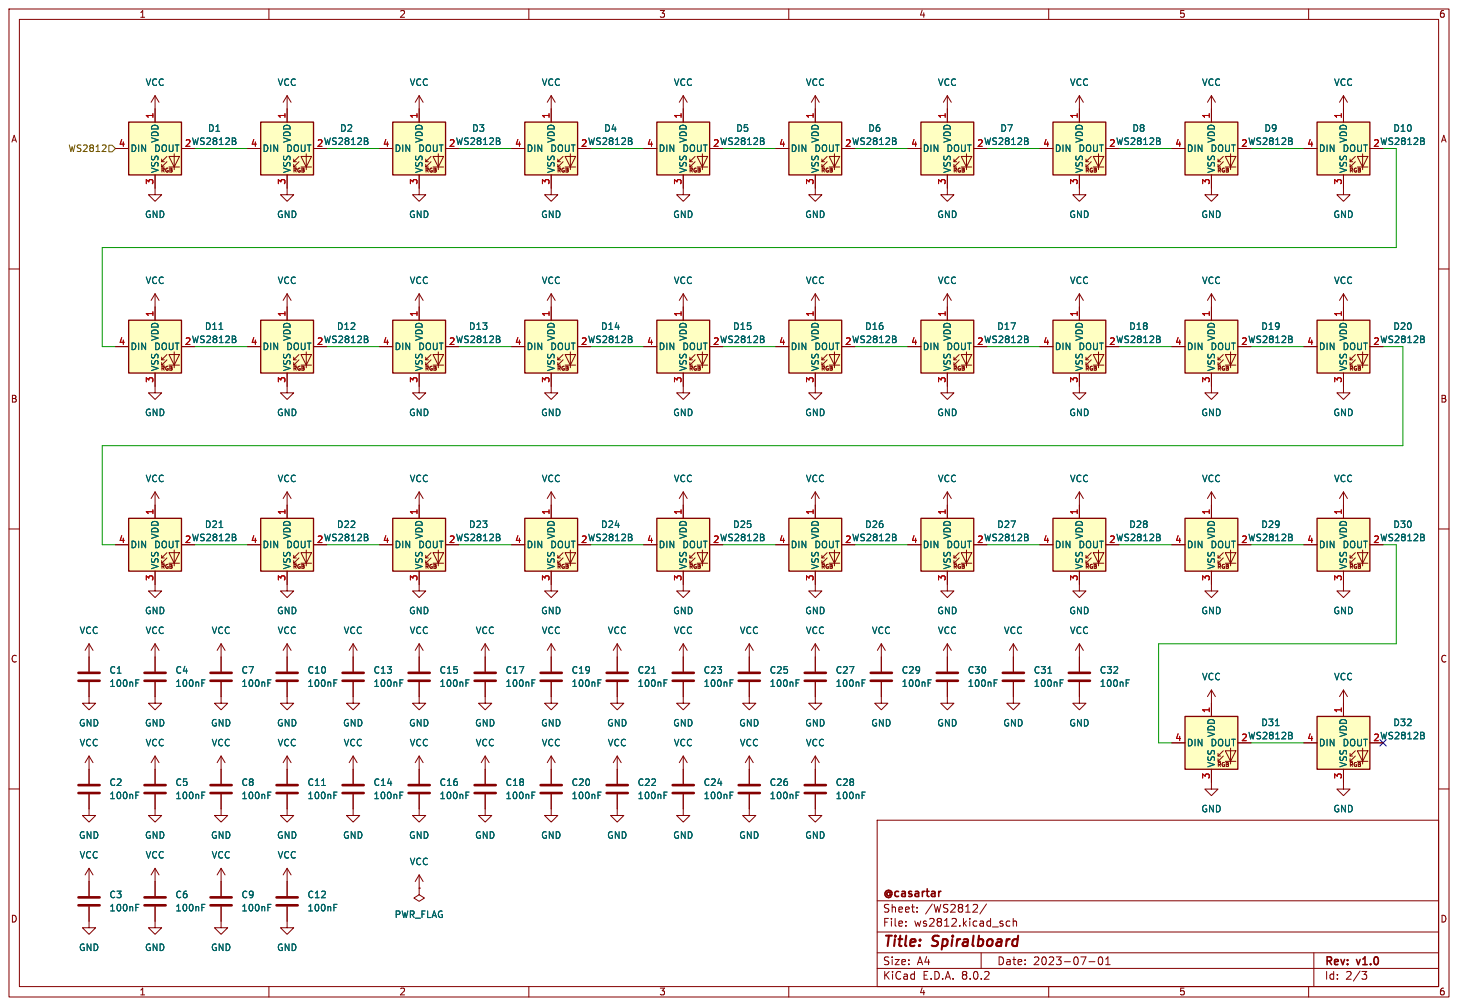
[picture p105: page 2]

3 DIN 4 D1 WS2812B GND GND GND GND GND GND

3 DIN 4 GND GND GND

3 DIN 4 VCC VCC GND GND

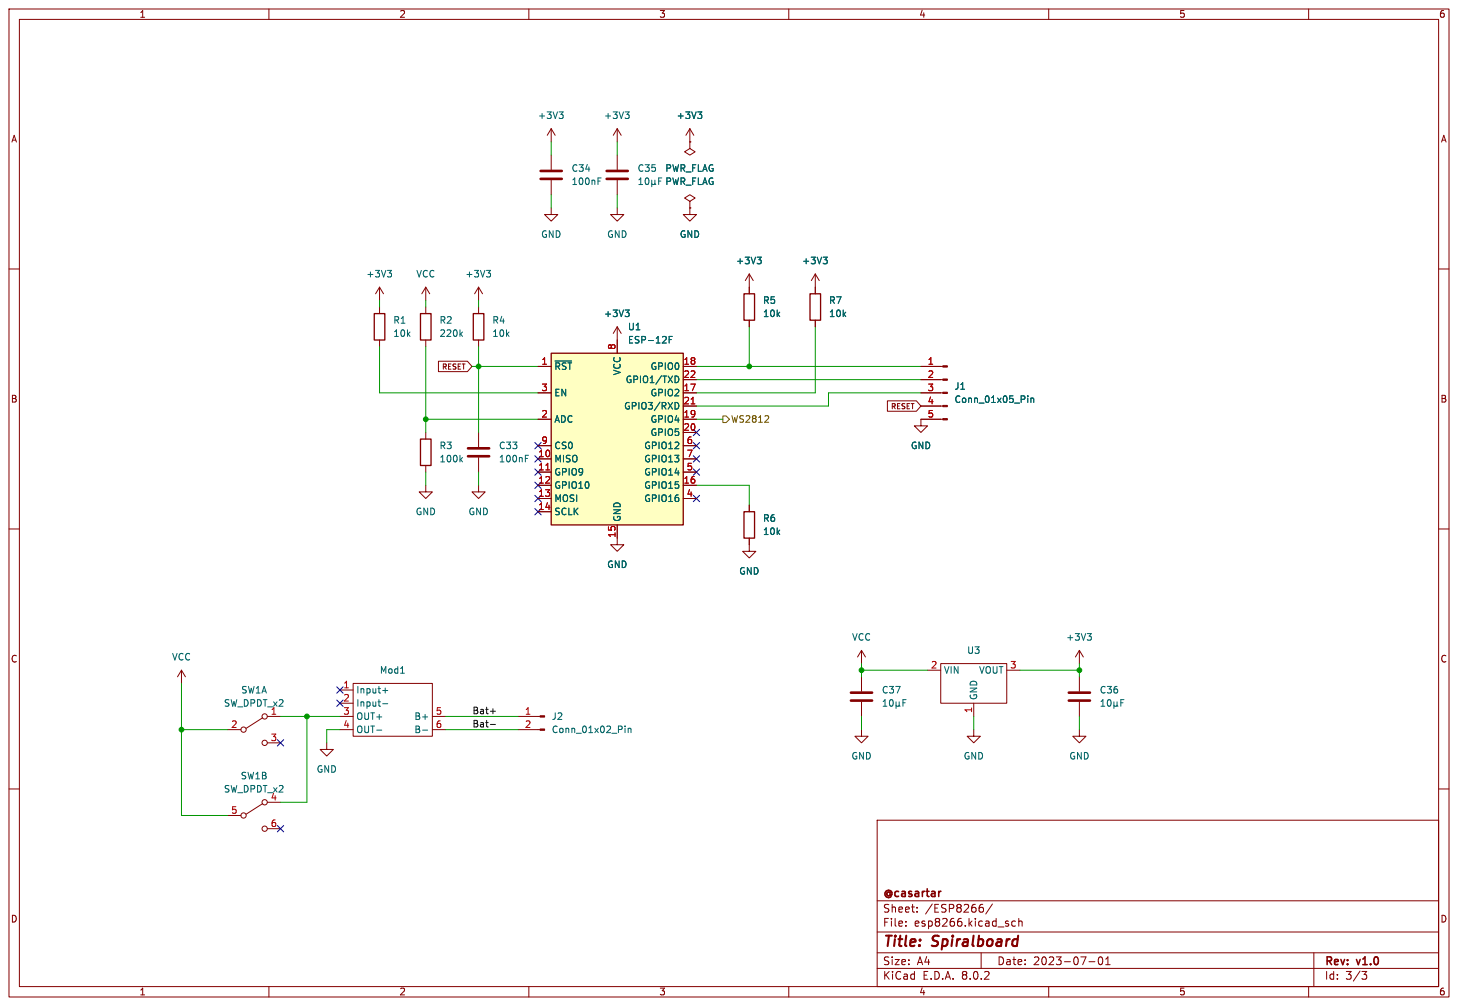
[picture p106: page 3]
