casartar/Spiralboard/MISC/Plakat/Plakat.pdf

32€

## Spiralboard

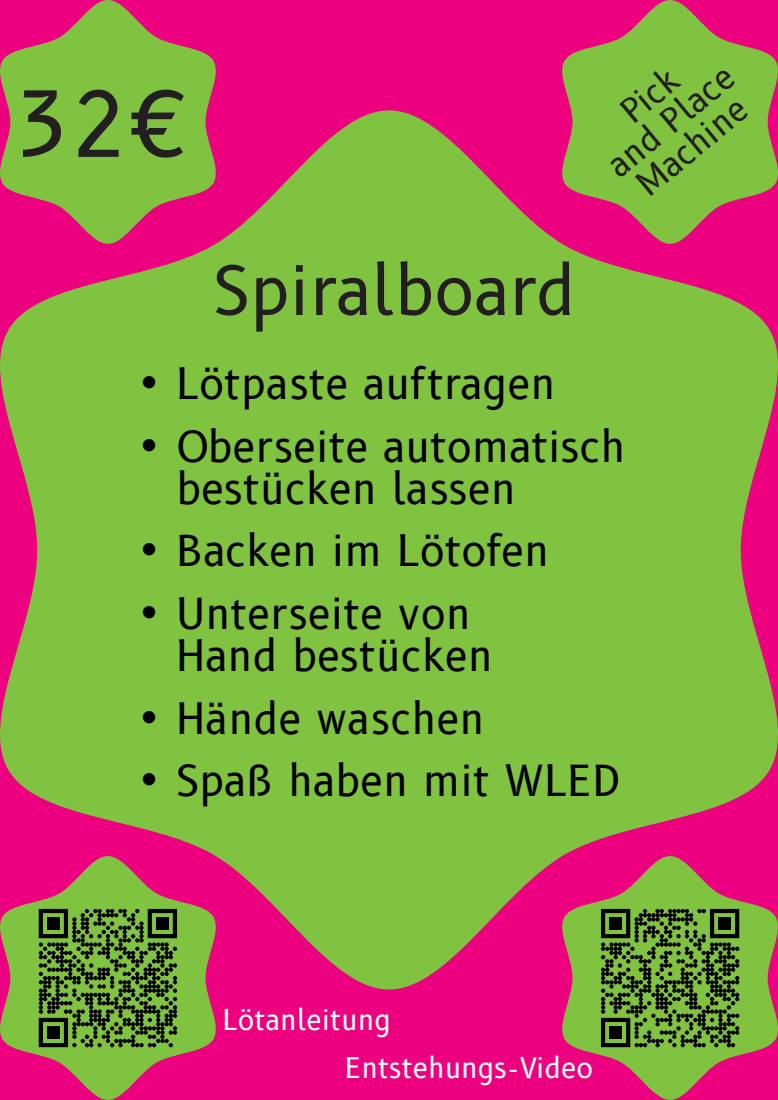
[picture p107: page 1]
Pick; and Place Machine; Entstehungs-Video; Lötanleitung

• Lötpaste auftragen
• Oberseite automatisch
bestücken lassen
• Backen im Lötofen
• Unterseite von
Hand bestücken
• Hände waschen
• Spaß haben mit WLED
