casartar/Spiralboard/(commit log)

2023-07-02 mouting hole vergrößert
    [spiralboard.kicad_pcb, spiralboard.kicad_sch]
2023-07-06 Linearregler getauscht, schalter hinzugefügt
    [esp8266.kicad_sch, spiralboard.kicad_pcb, spiralboard.kicad_sch, ws2812.kicad_sch]
2023-09-14 move files to PCB folder
    [esp8266.kicad_sch, spiralboard.kicad_pcb, spiralboard.kicad_sch, ws2812.kicad_sch]
2023-09-20 Warteliste für Gäste und Mitglieder separat
2024-05-19 docu update, add schematic pdf, file updates
    [esp8266.kicad_sch, spiralboard.kicad_pcb, spiralboard.kicad_sch, ws2812.kicad_sch]
2026-01-02 add dxf and step of spiralboard pcb for housing development
    [spiral_board_outline2.dxf, spiralboard.step]
